hutscape/pine/readme.md

# Pine

> 🌲 Indoor Infrared receiver and transmitter with temperature sensor 🎐

Visit [hutscape.com/pine](https://hutscape.com/pine) for more details.

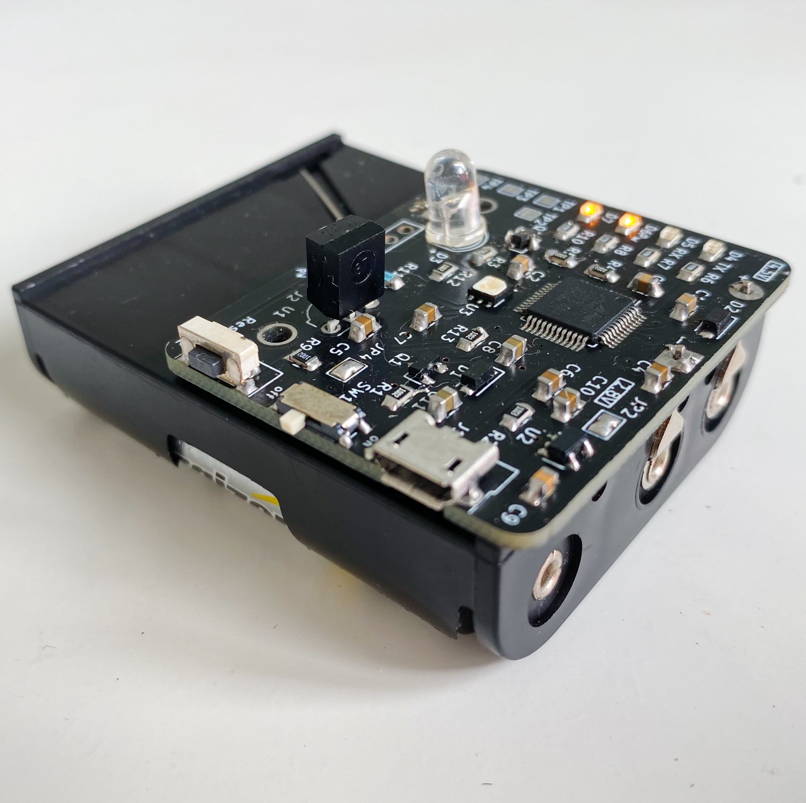
[picture p1: images/prototype/front.jpg]
