hutscape/pine/hardware.md

---
layout: pcb
title: PCB
permalink: /pcb
sequence: 2

three_d: true
pcb_layout: true
manufacturing: false
gerber: true
---
