hutscape/pine/index.md

---
layout: start
title: Start
permalink: /
sequence: 1

manufacturing: true
downloads:
  code: true
  schematic: true
  layout: true
  kicad: true
  gerber: true
  bom: true
  freecad: false
  case: false
features:
  - detail: Record and store the ON and OFF aircon commands with IR receiver
  - detail: Turn on or off the aircon with the IR emitter
  - detail: Measure temperature of another part of the room
  - detail: Go into sleep mode after turning on or off the aircon
---
