hutscape/pine/_code/demo.md

---
layout: code
title: Demo
description: Send ON and OFF commands to the aircon
difficulty: medium
features:
  - infrared
  - IR
  - emit
  - aircon
images:
  console: demo-console.png
references:
  - name: Use Arduino AVR Board version 1.6.21
    url: https://forum.arduino.cc/index.php?topic=574020.0
  - name: IRLib2 for Arduino Infrared
    url: https://github.com/cyborg5/IRLib2
  - name: Raw emit code example
    url: https://github.com/cyborg5/IRLib2/blob/master/IRLib2/examples/rawSend/rawSend.ino
---
