hutscape/pine/pcb/pcb.md

---
layout: pcb
title: PCB
permalink: /pcb
sequence: 2

# maximum number of images prototype-n.jpg in folder images/pcb/prototype
max_prototype_images: 3

three_d: true
pcb_layout: true
manufacturing: false
gerber: true
---
