hutscape/pine/_code/ir-receive.md

---
layout: code
title: IR receive
description: Receive and display raw IR code
difficulty: medium
features:
  - infrared
  - IR
  - receive
  - aircon
references:
  - name: Use Arduino AVR Board version 1.6.21
    url: https://forum.arduino.cc/index.php?topic=574020.0
  - name: IRLib2 for Arduino Infrared
    url: https://github.com/cyborg5/IRLib2
  - name: Raw receive code example
    url: https://github.com/cyborg5/IRLib2/blob/master/IRLib2/examples/rawRecv/rawRecv.ino
---
