hutscape/pine/_code/ir-raw-emit-zero.md

---
layout: code
title: Emit raw infrared code
description: This code takes in a raw dump of IR and emits it using Arduino Zero with SAMD21G micro-controller on a crystalless custom PCB.
difficulty: medium
features:
  - infrared
  - IR
  - emit
  - raw

references:
  - name: Use Arduino AVR Board version 1.6.21
    url: https://forum.arduino.cc/index.php?topic=574020.0
  - name: IRLib2 for Arduino Infrared
    url: https://github.com/cyborg5/IRLib2
  - name: Raw emit code example
    url: https://github.com/cyborg5/IRLib2/blob/master/IRLib2/examples/rawSend/rawSend.ino
---
