hutscape/pine/images/design/subsystem.png

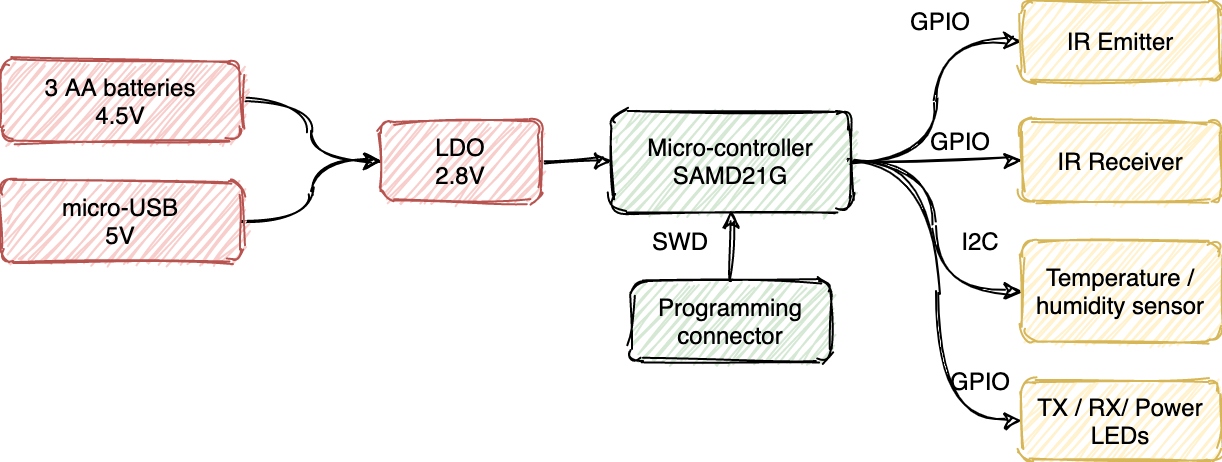
images/design/subsystem.png
