hutscape/pine/images/lessons/9-pin-jtag-swd-pins.png

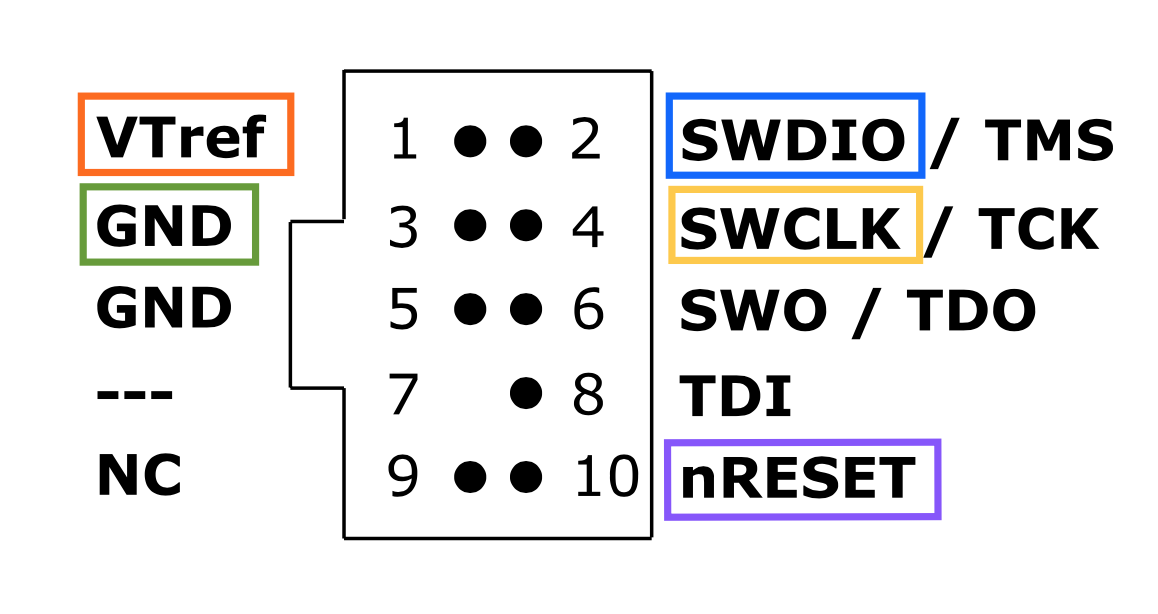
images/lessons/9-pin-jtag-swd-pins.png
