hutscape/pine/images/pcb/3dview-front.png

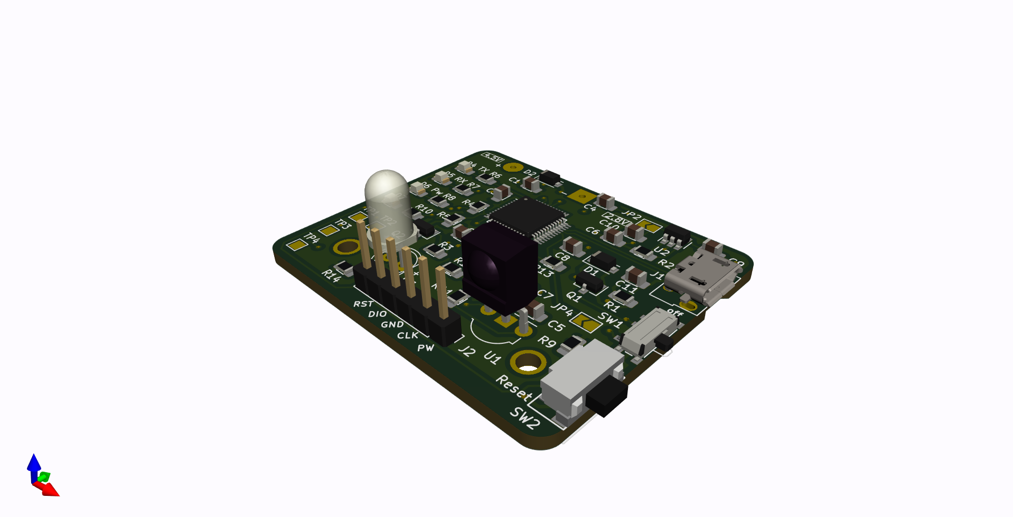
images/pcb/3dview-front.png
