hutscape/pine/images/pcb/3dview-side1.png

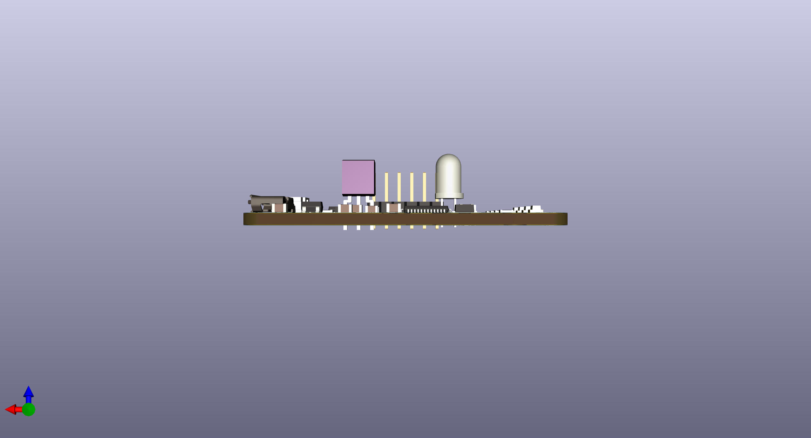
images/pcb/3dview-side1.png
