hutscape/pine/images/pcb/3dview-side2.png

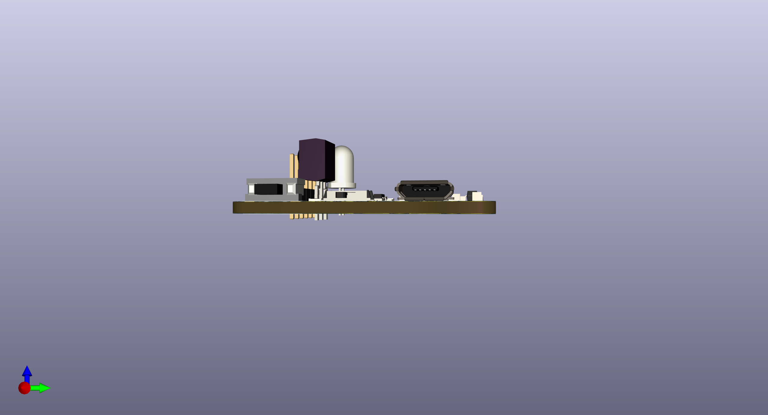
images/pcb/3dview-side2.png
