hutscape/pine/images/pcb/3dview-side4.png

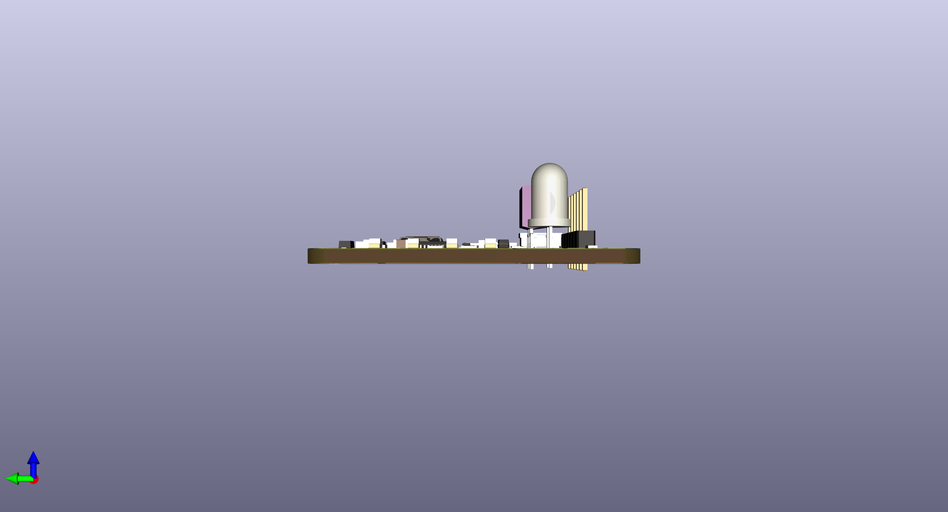
images/pcb/3dview-side4.png
