hutscape/pine/images/pcb/layout-back.png

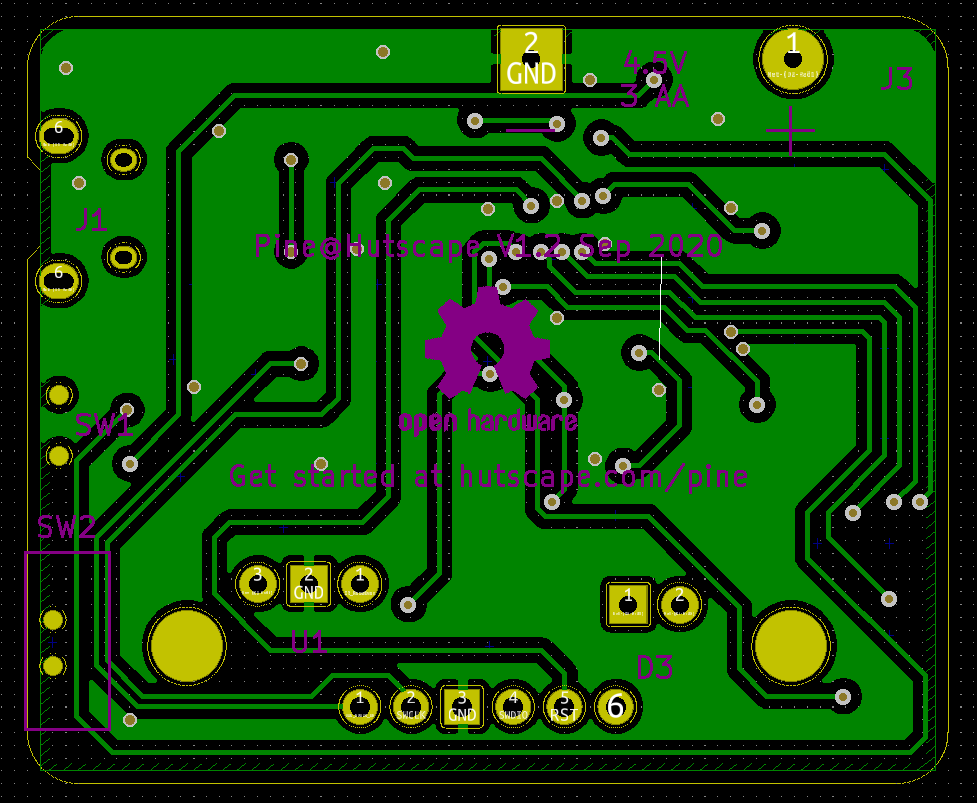
images/pcb/layout-back.png
