hutscape/pine/images/pcb/layout-front.png

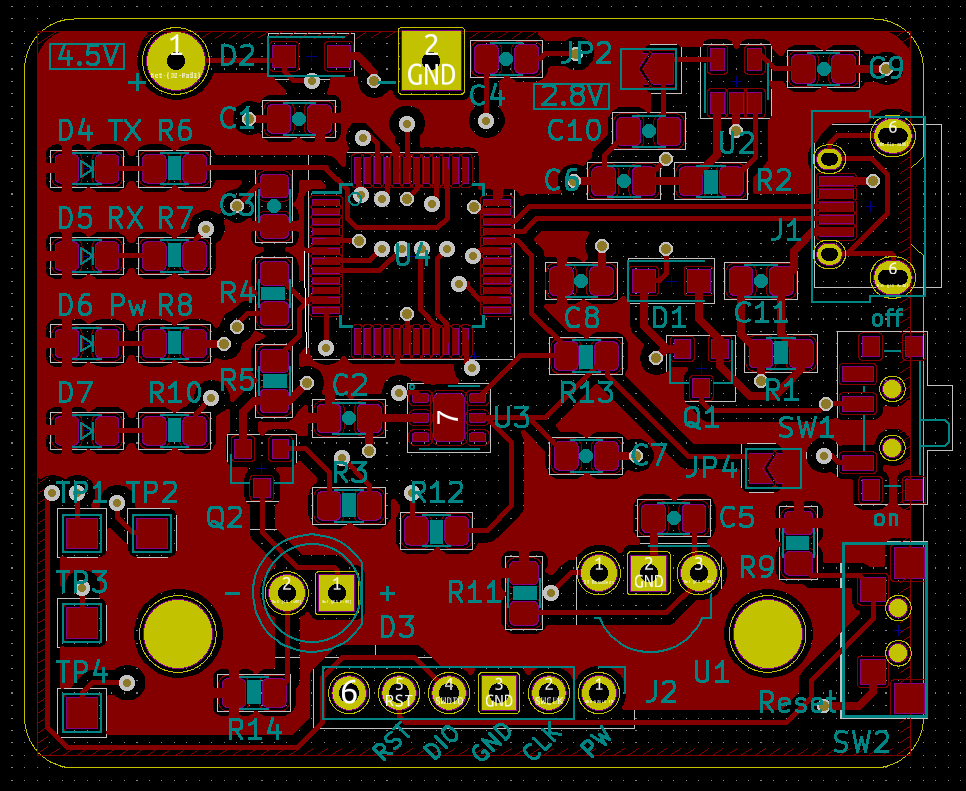
images/pcb/layout-front.png
