hutscape/pine/images/pcb/schematic.png

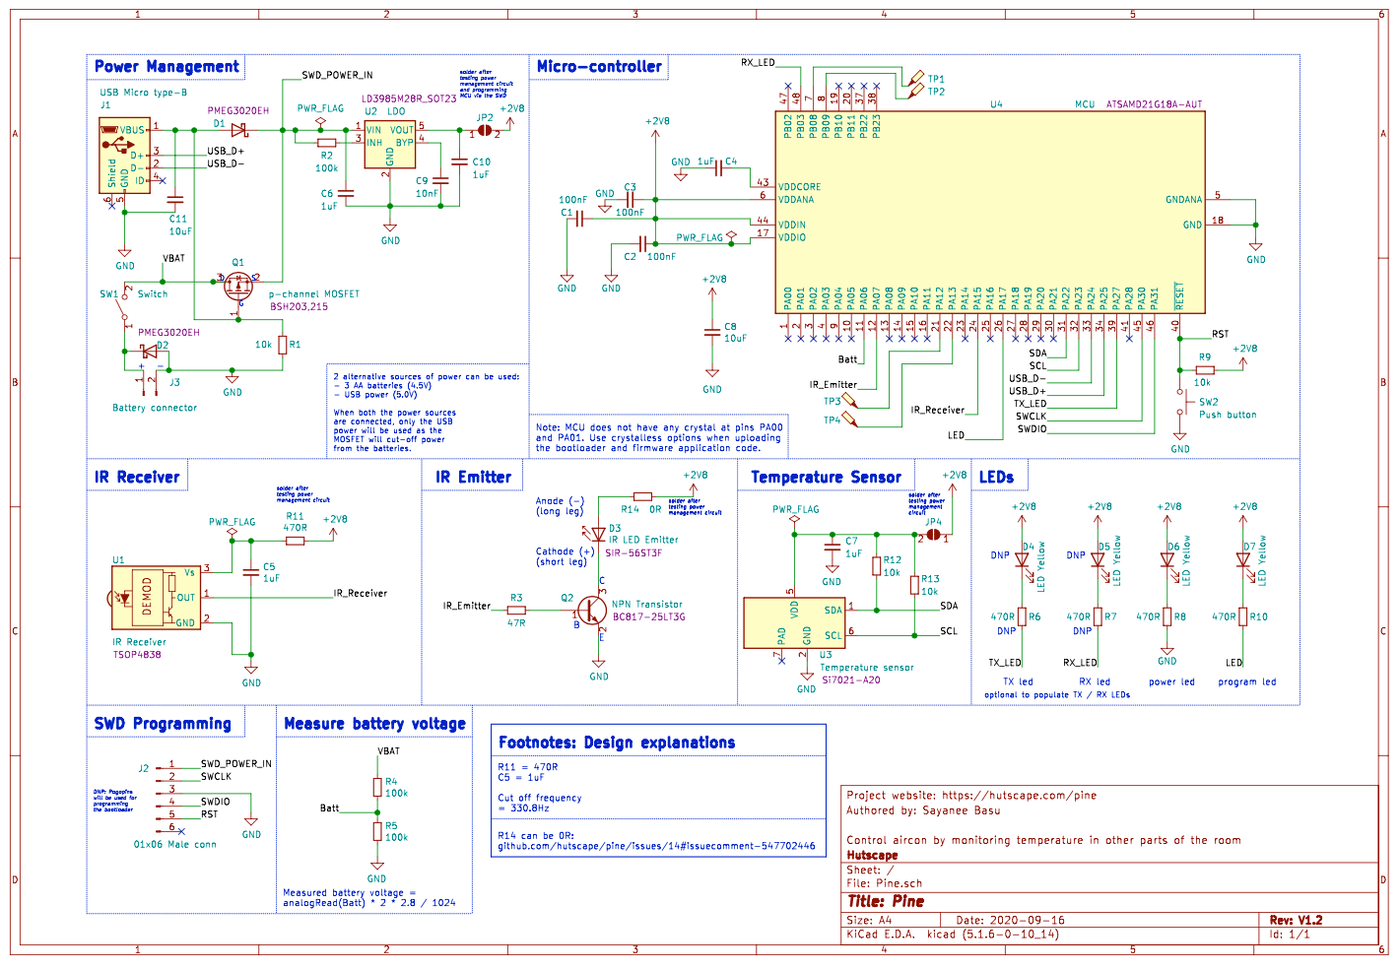
images/pcb/schematic.png
