hutscape/pine/images/power/power_tree.png

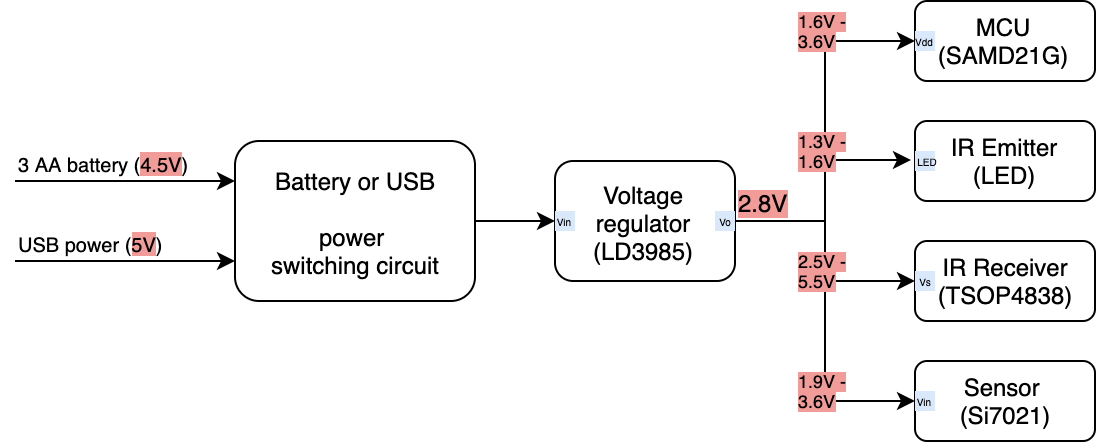
images/power/power_tree.png
