hutscape/pine/images/prototype/back.jpg

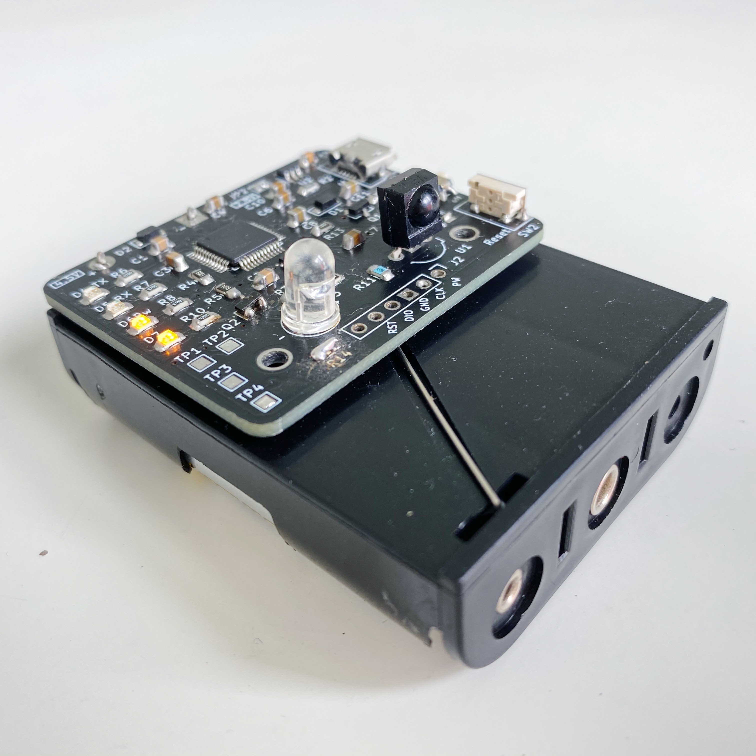
images/prototype/back.jpg
