hutscape/pine/images/prototype/prototype-2.jpg

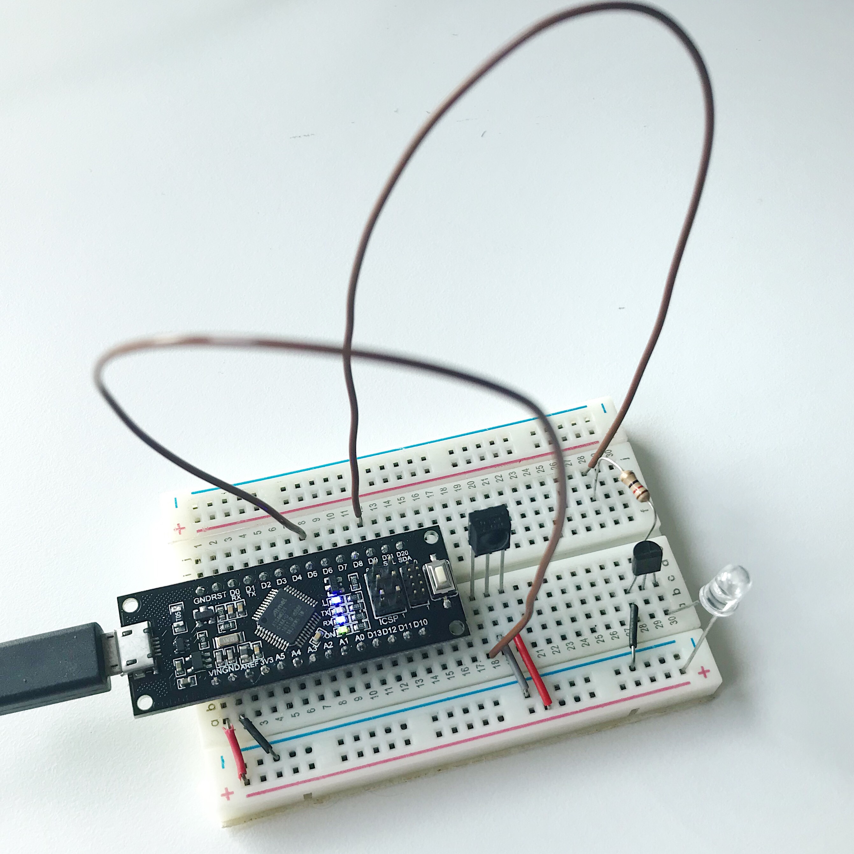
images/prototype/prototype-2.jpg
