hutscape/pine/images/prototype/prototype-3.jpg

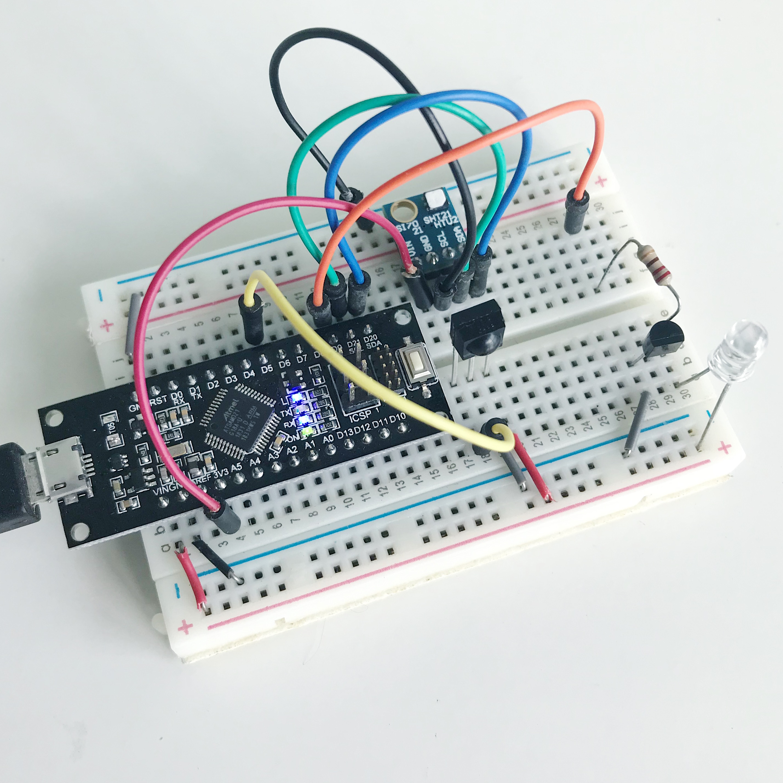
images/prototype/prototype-3.jpg
