hutscape/pine/images/prototype/side.jpg

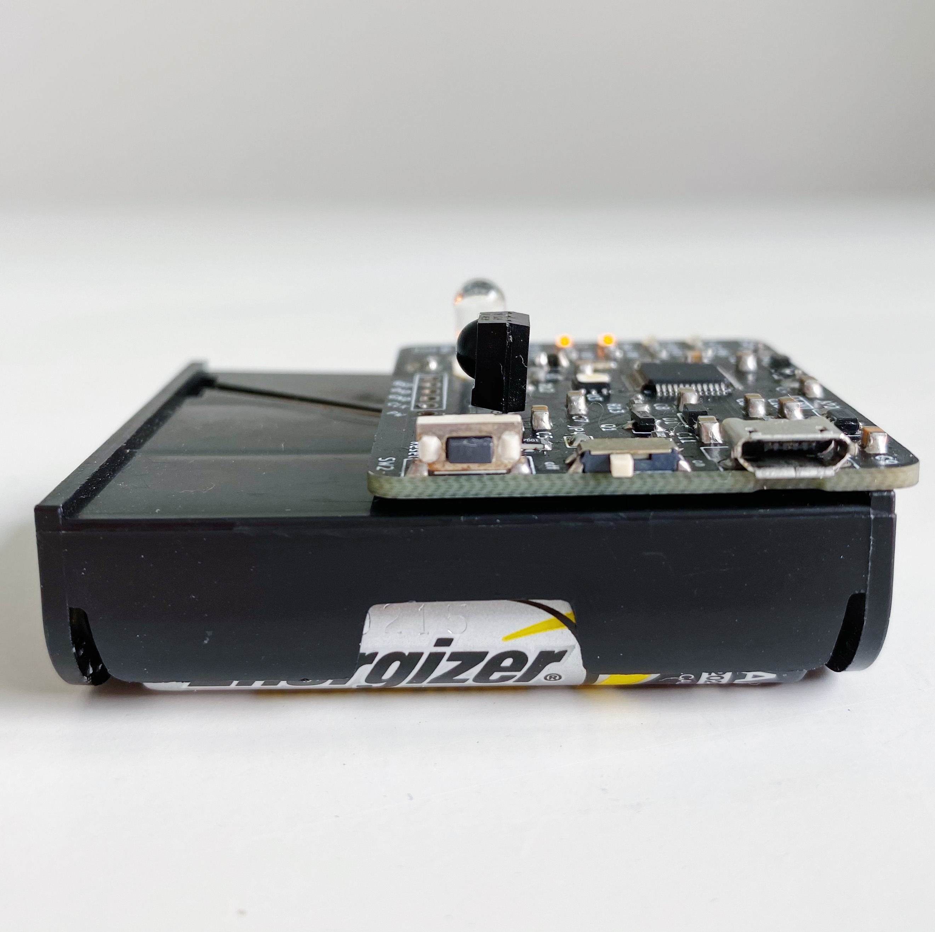
images/prototype/side.jpg
