hutscape/pine/images/prototype/top.jpg

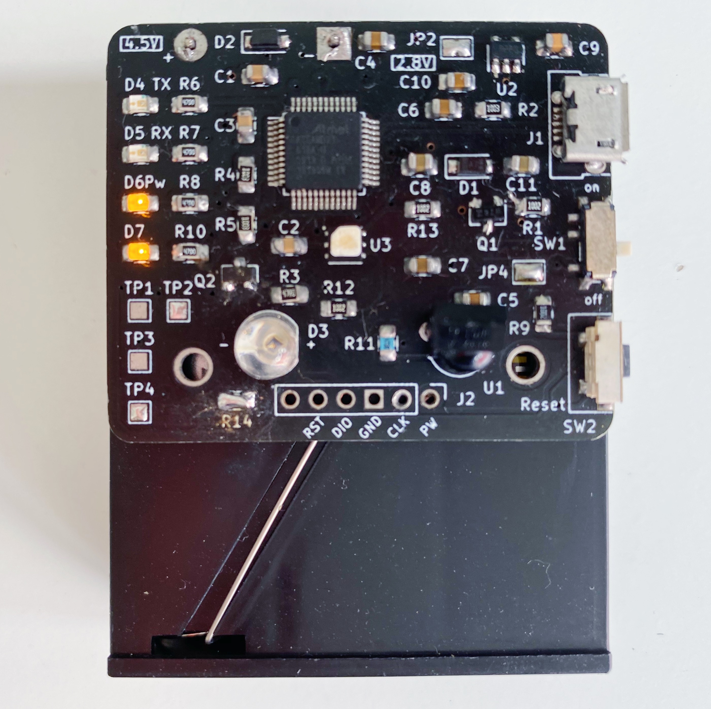
images/prototype/top.jpg
