hutscape/pine/start/step1.md

**Battery holder**

The PCB has 2 battery holder connector holes that can be used to attach the battery holder.

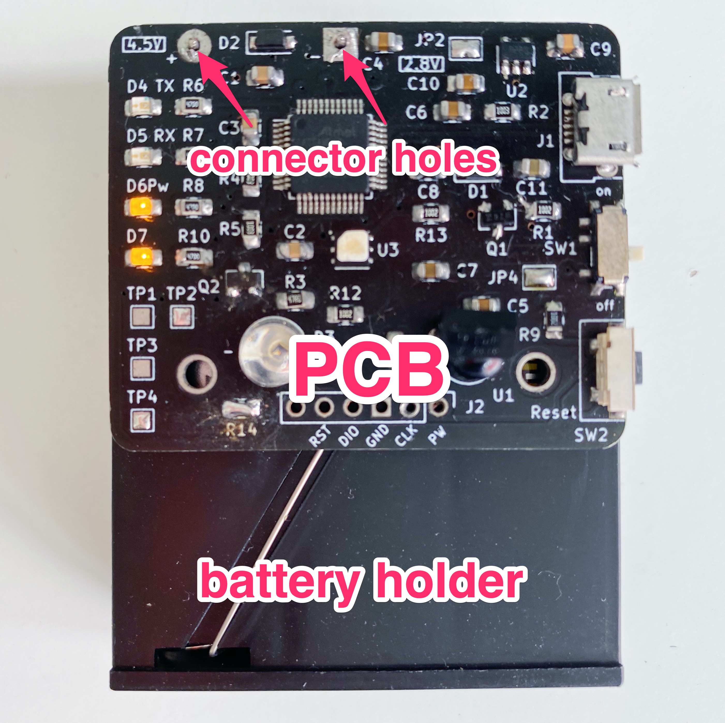
[picture p27: images/prototype/pcb-connector.jpg]
PCB battery connector holes


**Batteries**

Put in 3 AA batteries and turn on the switch. The power LED should turn on.

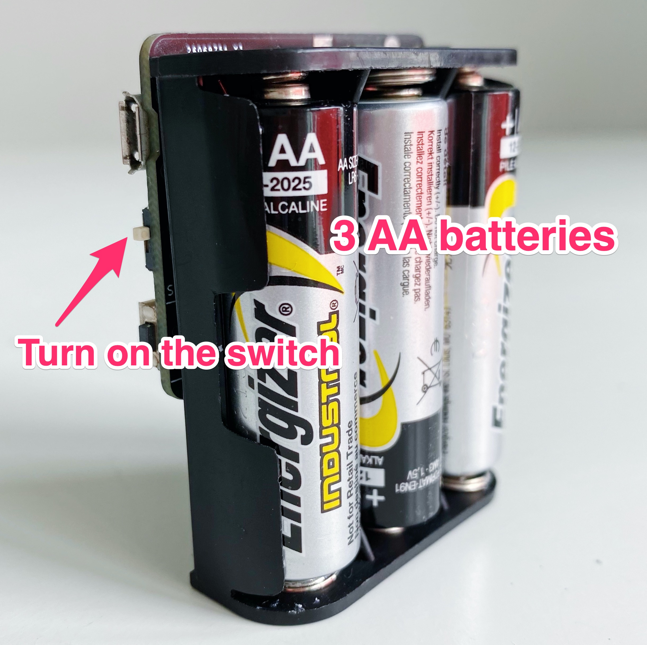
[picture p28: images/prototype/battery.jpg]
PCB with battery holder
