hutscape/pine/start/step2.md

**Upload the firmware**

Flash the [firmware](software#firmware) onto the Arduino Zero compatible board with a micro-USB cable.

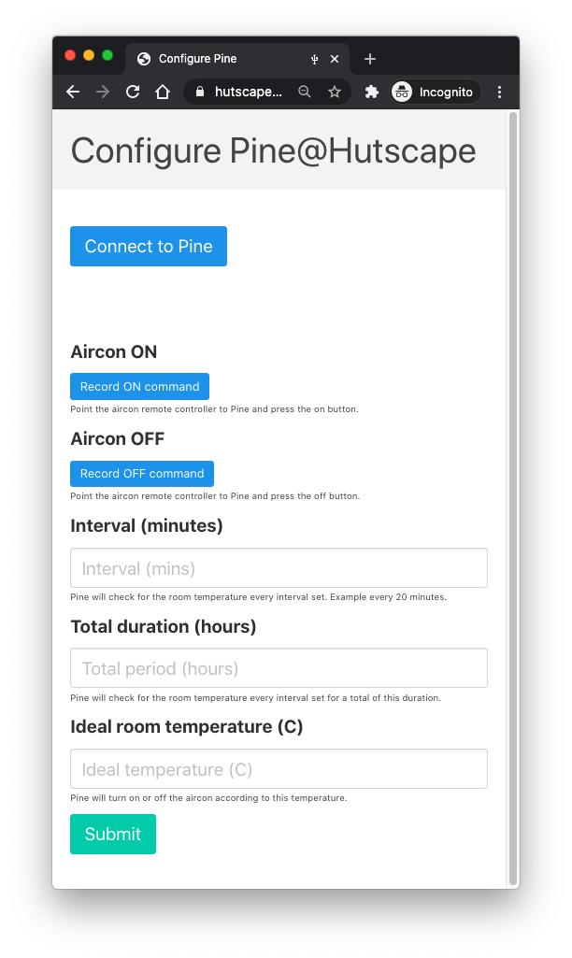
[picture p29: images/prototype/setup-page.png]
Web USB setup page


**Serial monitor**

Connect to the serial monitor to see the debug messages.

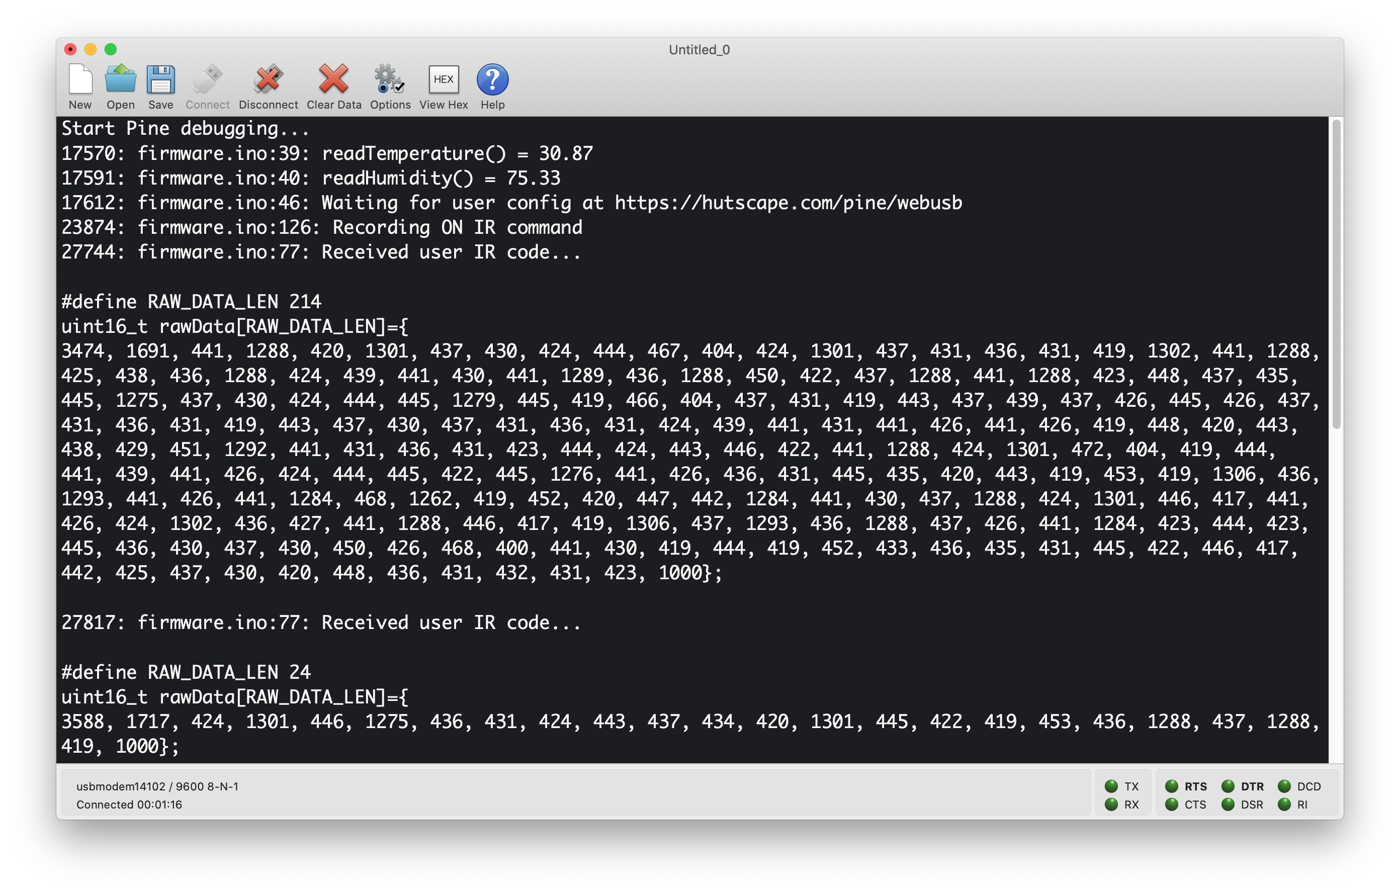
[picture p30: images/prototype/serial.png]
Serial console
