hutscape/pine/start/step3.md

<!-- TODO: Program the actual sleep and turning on to check the temperature -->
**Notice that the aircon should turn ON and OFF every 5 seconds as a test.**
