hutscape/pine/_code/test.md

---
layout: code
title: Pine test
description: Run a verification test to ensure all features are working
difficulty: medium
features:
  - infrared
  - IR
  - emit
  - aircon
images:
  console: test-console.png
references:
  - name: Use Arduino AVR Board version 1.6.21
    url: https://forum.arduino.cc/index.php?topic=574020.0
  - name: IRLib2 for Arduino Infrared
    url: https://github.com/cyborg5/IRLib2
---
