hutscape/pine/_code/measure-battery-zero.md

---
layout: code
title: Measure battery voltage
description: VBAT is connected to the battery or voltage source you wish to measure the voltage of.
difficulty: easy
features:
  - battery
  - voltage

images:
  console: measure-battery-zero-console.png
  schematic: measure-battery-zero-schematic.png
references:
  - name: Adafruit Feather M0 Adalogger
    url: https://learn.adafruit.com/adafruit-feather-m0-adalogger/power-management
---
