hutscape/pine/images/code/test-console.png

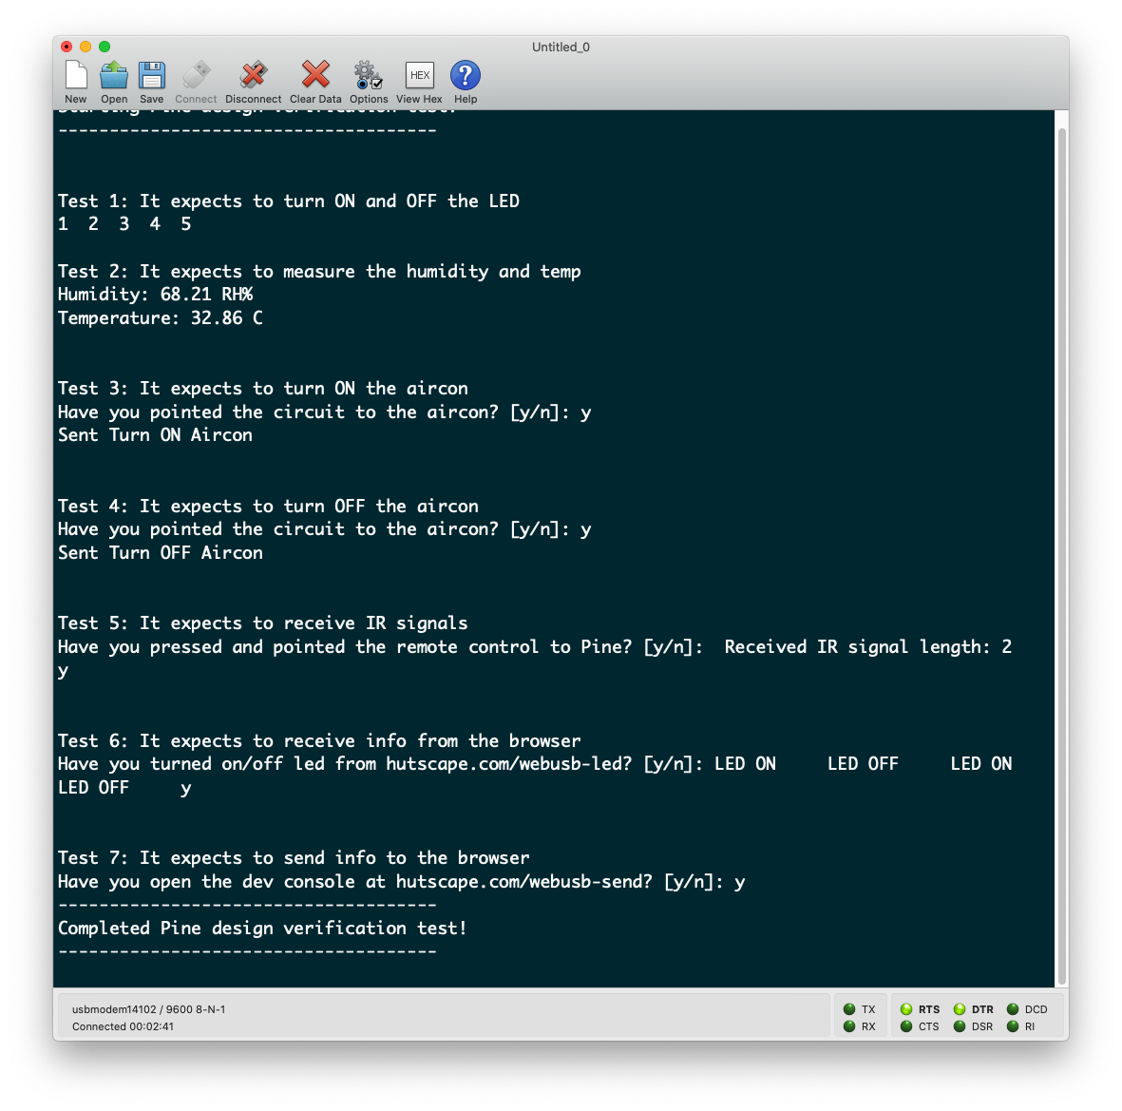
images/code/test-console.png
