hutscape/pine/(threads)

Thread 2 (2019-09-22):

Create new footprint for USB Micro-B

sayanee, 2019-09-22:
- [Datasheet](https://datasheet.lcsc.com/szlcsc/Jing-Extension-of-the-Electronic-Co-LCSC-MICRO-USB-5S-B-Type-horns-High-temperature_C10418.pdf)
    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
- [Vendor](https://lcsc.com/product-detail/USB-Connectors_Jing-Extension-of-the-Electronic-Co-Jing-Extension-of-the-Electronic-Co-MICRO-USB-5S-B-Type-horns-High-temperature_C10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)
- Edit from existing footprint: `USB_Micro-B_Amphenol_10103594-0001LF_Horizontal`
    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

sayanee, 2019-09-23:
Edited footprint:

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

Closed with https://github.com/hutscape/kicad-library/commit/c9657751e4f665b2ee2351194562116754cd3596

Closed 2019-09-23.

Thread 3 (2019-09-23):

Connect GND of measuring batt to a digital GPIO pin

sayanee, 2019-09-23:
> Little suggestion for your battery level measurements (you probably just didn't need this optimization yet): You can replace the GND with a GPIO that you ground only when you do the measures and set as output otherwise (high impedance).

~ [source](https://twitter.com/CedHon/status/1176085302055772160)

sayanee, 2019-09-23:
## Before:

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

## After:

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

Closed 2019-09-23.

Thread 4 (2019-09-23):

Improve power management circuit

sayanee, 2019-09-23:
> Remove D2 and reverse Q1. I use the circuit below. P1 is the battery, +5V is from USB

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

~ [source](https://twitter.com/ba0sh1/status/1176122249473978369) 🙏 Thanks Baoshi

sayanee, 2019-09-24:
Improved
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

sayanee, 2019-09-24:
Closed with 0bb40f7d23860e881d780033c68239684d94a1af

Closed 2019-09-24.

Thread 5 (2019-09-24):

Optimize power savings for power LED

sayanee, 2019-09-24:
> You also have an LED that's always on, maybe that's not mandatory. And it can be nice to double-check that the default state of this "switchable ground" GPIO is set as input by (hardware) default.

~ [Source](https://twitter.com/CedHon/status/1176176275268034560)

sayanee, 2019-10-25:
Something to think about in future projects, especially for a low power device! For now, just de-solder the resistor if required.

Closed 2019-10-25.

Thread 6 (2019-09-24):

Pull out some unused pins for future experimentation

sayanee, 2019-09-24:
> (+ adding a couple of test points on unused GPIOs can't hurt!)

~ [source](https://twitter.com/CedHon/status/1176176275268034560)

Example from [PRJC teensy](https://www.pjrc.com/store/teensy36b.jpg)

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

sayanee, 2019-10-24:
Using schematic:

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

Using footprint:

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

sayanee, 2019-10-25:
## Schematic

`TP1`, `TP2`, `TP3`, `TP4`

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

## Layout

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

Closed 2019-10-25.

Thread 7 (2019-09-24):

Add reference URLs for power measurement

sayanee, 2019-09-24:
- [Measuring Lithium battery voltage with nRF52](https://devzone.nordicsemi.com/nordic/nordic-blog/b/blog/posts/measuring-lithium-battery-voltage-with-nrf52) from [source](https://twitter.com/CedHon/status/1176431072583868416)
- [RC Charging circuit](https://www.electronics-tutorials.ws/rc/rc_1.html) from [source](https://twitter.com/CedHon/status/1176425937153515523)

Closed 2019-10-24.

Thread 8 (2019-10-23):

Add 3D models in proper paths and credits

sayanee, 2019-10-23:
- [smd side push button](https://grabcad.com/library/smd-side-push-button-2x4x3-5-mm-1)
- [micro USB](https://grabcad.com/library/micro-usb-1)

sayanee, 2019-10-24:
- Added 3d models folder: https://github.com/hutscape/kicad-library/tree/master/3d_models
- Check `readme.md`: https://github.com/hutscape/kicad-library#3d-models

Closed 2019-10-24.

Thread 9 (2019-10-24):

Improve component placement

sayanee, 2019-10-24:
Thanks @notthetup 🙇‍♀

- [x] Micro USB jutting outwards or inwards for edge cut
- [x] Create custom footprint for diode and LEDs to show the direction https://github.com/hutscape/kicad-library/commit/fab1f1fe7deaafd18e501e6e459cb8820d0edcaf
- [x] Associate all LED, diodes, Resistors, Capacitors to the new footprint!
- [x] Label ON / OFF for SW1 on the silkscreen
- [x] remove the triangle in Micro USB silkscreen
- [x] Increase height of the PCB edge cut by 1 grid of 25 mils above the battery connectors
- [x] Label all connected pins of the `SWD` header
- [x] Create more space around bigger components for soldering

sayanee, 2019-10-24:
✅ Increase the height of the PCB edge cut by 1 grid of `25 mils` above the battery connectors

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

sayanee, 2019-10-24:
✅ Micro USB jutting outwards or inwards for edge cut
✅ Remove the triangle in Micro USB silkscreen

## Before

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

## After

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

sayanee, 2019-10-24:
✅ Label ON / OFF for SW1 on the silkscreen

## Before

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

## After

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

sayanee, 2019-10-24:
## Before

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

## After

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

Closed 2019-10-24.

Thread 11 (2019-10-26):

Update power tree schematic with the new LDO

sayanee, 2019-10-26:
https://hutscape.com/pine/power#main-components

sayanee, 2019-10-27:
Closed with https://github.com/hutscape/pine/commit/4b87898ae2660ef1557bcb1c2a032019eb097d80

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

Closed 2019-10-27.

Thread 13 (2019-10-26):

Find out KiCad shortcuts

sayanee, 2019-10-26:
- drag traces
- change from front to back layers and vice versa
- draw traces, drop via, continue on the bottom layer

Thread 14 (2019-10-27):

Comments on routing / layout

sayanee, 2019-10-27:
from @notthetup

- [x] `M2` drill holes should be non-plated and non-conducting
- [x] Check the clearance for traces near the drill holes
- [x] TH for `SW1` and `SW2` should be non-plated

from @catmaker

- [x] Link `BATT_EN` to `GND` or an FET 75e1301ccccc7d52c6a0b5bb4e9a9f3ccf367959

> Without download the datasheet of ATSAM, I can observe you're stressing the `PA06` & `PA16` (`batt` & `batt_en`) pins. Despite the limiting the current with `100kohms`, you're back-powering the MCU at whatever batt voltage when the CPU is only at 2.8V. That stress can cause strange behavior over time.

> In the past, I read in (I think) Energizer AA Alkaline Spec/AppNote that anything less than 50uA loading is better than its self-discharge (kind of like the battery's shelf-life) and is good for off-state of consumer goods. 4.5V / 200000 = 22.5uA, so that's good. But your LDO consumes > 85uA, not the best. The good ones I've used in the past were Microchip MCP1703 (2uA) and OnSemi NCP170 (0.5uA) These little savings can add up to your longer batt life.

> If the batt reader is really a drainer, then the solution is a P-MOSFET at the top-arm of your potential divider, but that needs to pull down to turn on, so an inverting transistor logic might be necessary -- additional components

- [x] Interchange `S` and `D` for symbol `BSH203` https://github.com/hutscape/pine/commit/6327a1abf4abe902c7cc7e73cfac4355dcd7c542

> the symbol for BSH203 looks like source and drain reversed. it's only the letters S & D that are interchanged. for sot23 or other 3-pin smt mosfets, they're pretty much standard. 1,2,3=g,s,d.

- [x] Remove an extra solder jumper bb0ccd3980dc61c12f9f01d6dd0fe4af4ed66e95

> JP1 looks redundant when `R11` can do the same

- [x] `D3` IR LED needs a series resistor 2239f77a734cb89488afc2f2a5789bc40af238e2

> are you controlling current through D3 IRLED with the transistor in linear region? You need to decouple the rail to the LED too, because it is a pulsating drain on the supply. In the past, we treated that NPN as a switch and control current along the LED. Although more expensive (cents) i will lazily use n-mosfet.

>  LED current is usually limited(controlled) by a series resistor. You can control an NPN current flow by controlling the base-current, multiplied by NPN's hfe, BUT this is exotic and probably not realizable (due to NPN manufacturing tolerances). So the common way is to treat that NPN as a quick on-off >switch<. So to control current, the series resistor is used.

> When batt power is low, and you xmit, the power rail is disturbed and possibly MCU is reset/browned-out prematurely. If you look at other similar circuits, the LED (only) is supplied by Vbatt, before the regulator.

@shannietron

- [ ] Add thermal reliefs on the solder jumper pads

> not a huge deal, but this pad doesn't have thermal relief.

- [x] Change to `GND` or add a FET to the battery measuring circuit 75e1301ccccc7d52c6a0b5bb4e9a9f3ccf367959

> the battery sense circuit, the Batt_EN is used to 'turn off' the sensing to save power but `Batt_EN` is at `2.8V` when high. your `VBAT` is going to be at `~3.7V`, and your `BAT_EN` will be at `2.8V`. you'll still have a current flow: `4.5µA`

sayanee, 2019-10-28:
`M2` drill holes are NPTH, mechanical

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

sayanee, 2019-10-28:
`SW1` has NPTH, mechanical drill hole

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

`SW2` has NPTH, mechanical drill hole

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

sayanee, 2019-10-29:
Interchange `S` and `D` for symbol `BSH203`

From the [datasheet](https://docs-apac.rs-online.com/webdocs/0f74/0900766b80f74f2c.pdf):

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

sayanee, 2019-10-30:
Link `BATT_EN` to `GND`

## Before

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

## After

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

sayanee, 2019-10-30:
#  `D3` IR LED needs a series resistor

## Calculate the value of the resistor

- `D3` IR LED Absolute maximum rating Pulse forward current is `500mA`
    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
- `80%` of maximum Pulse forward current is `400mA`
- `D3` IR Led forward voltage is `1.3V`
    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
- `Vce` is `2.8V - 1.3V = 1.5V`
    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
- `D3` IR LED PWM is at `38kHz` - ([reference](https://github.com/cyborg5/IRLib2/blob/167a9213262d3d5c969e887e48b8bd2d610811f2/IRLibProtocols/IRLib_HashRaw.h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))
- Maximum duty cycle of the raw IR code will be `3446 ms` or `3.446us` - ([reference](https://github.com/hutscape/pine/blob/75e1301ccccc7d52c6a0b5bb4e9a9f3ccf367959/firmware/data.h#L4))
- Approximate value of resistor = `1.5V / 400mA = 3.75Ω ≃ 0Ω`
- Safe operating area of `Q2` NPN Transistor
    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

## Value of resistor chosen

- `0Ω` or `10Ω`
- Replace `JP3` with ``0Ω` resistor

Closed 2019-11-06.

Thread 15 (2019-10-30):

Add firmware features

sayanee, 2019-10-30:
- [ ] Record and store IR raw codes, ideal temperature, interval and duration
- [ ] Measuring battery voltage
- [ ] Displaying low battery voltage with LED
- [ ] Sleep and wakeup periodically to check the temperature and turn on/off the aircon

sayanee, 2020-10-05:
- [ ] implement task with sleeping and wakeup
- [ ] fix form validation when IR raw code is added

Thread 16 (2019-11-06):

Replace schottky diode

sayanee, 2019-11-06:
## Before

**30V 2A** 430mV @ 2A **SOD-123F** Schottky Barrier Diodes (SBD) RoHS [MBR230LSFT1G](https://lcsc.com/product-detail/Schottky-Barrier-Diodes-SBD_ON-Semicon_MBR230LSFT1G_ON-Semicon-ON-MBR230LSFT1G_C126673.html)

## After

Nexperia **30V 2A**, Diode, 2-Pin **SOD-123F** [PMEG3020EH,115](https://sg.rs-online.com/web/p/rectifier-diodes-schottky-diodes/0485319/?sra=pstk)

Changes to make:

- [x] BOM
- [x] Schematic component info: datasheet, part no., vendor link

sayanee, 2019-11-14:
Closed with https://github.com/hutscape/pine/commit/ef6ed82db5cb6a8365c1f3287c254b81fa6909d8

Closed 2019-11-14.

Thread 17 (2019-11-17):

Silkscreen for SW1 is inverted.

notthetup, 2019-11-17:
SW1 turns on when the switch is in the downwards position. The silkscreen indicates otherwise.

Closed 2019-11-17.

Thread 18 (2020-07-01):

Touching the MCU will start the program

sayanee, 2020-07-01:
on the soldered PCB

sayanee, 2020-07-07:
Solved with #19

Closed 2020-07-07.

Thread 19 (2020-07-01):

Port will be detected upon intermittent plugging in and out the USB and pressing reset button

sayanee, 2020-07-01:
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

sayanee, 2020-07-07:
Solved by using the crystalless option for the PCB.

Details:

- [Bootloader for SAMD21G](https://hutscape.com/tutorials/arduino-bootloader-samd21g)
- [Flashing blinky firmware for SAMD21G ](https://hutscape.com/tutorials/blinky-samd21g)

Closed 2020-07-07.

Thread 20 (2020-07-07):

Temperature sensor does not work

sayanee, 2020-07-07:
# Logic Analyzer probed

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

# Serial monitor

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

sayanee, 2020-07-07:
Tested with another `Si7021` sensor and it works!

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

sayanee, 2020-08-05:
Replaced Si7021 chip. And it works now ✅

Closed 2020-08-05.

Thread 22 (2020-08-12):

IR LED is not working

sayanee, 2020-08-12:
Because `2N222A` pinout (used in breadboard) is different from `BC817`

# 2N222A

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

# BC817

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

## Differences

| Chip | PN222A | BC817 |
| ------ | ------ | ------ |
| Pin 1 | E | B
| Pin 2 | B | E
| Pin 3 | C | C

sayanee, 2020-08-12:
Changed schematic

## Before

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

## After

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

sayanee, 2020-08-12:
Change layout

sayanee, 2020-08-13:
closed with fbd26d9b4a6f8accae8da3f6b3ee31ed54a161b5

Closed 2020-08-13.

Thread 23 (2020-09-03):

Try uploading the bootloader by converting an ST-Link into a Black Magic Probe

sayanee, 2020-09-03:
Via [this link](https://microcontrollerelectronics.com/how-to-convert-an-stm32f103c8t6-into-a-black-magic-probe/)

As [suggested by Ubi](https://www.youtube.com/watch?v=h2nKROPlFy0&lc=Ugz_kLs8s2h8RKxxlqh4AaABAg.9BkZmUeflnr9Bka7kc6Eeu)

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

sayanee, 2020-09-05:
Trasferred

Closed 2020-09-05.
