hutscape/pine/pcb/docs/schematic.pdf

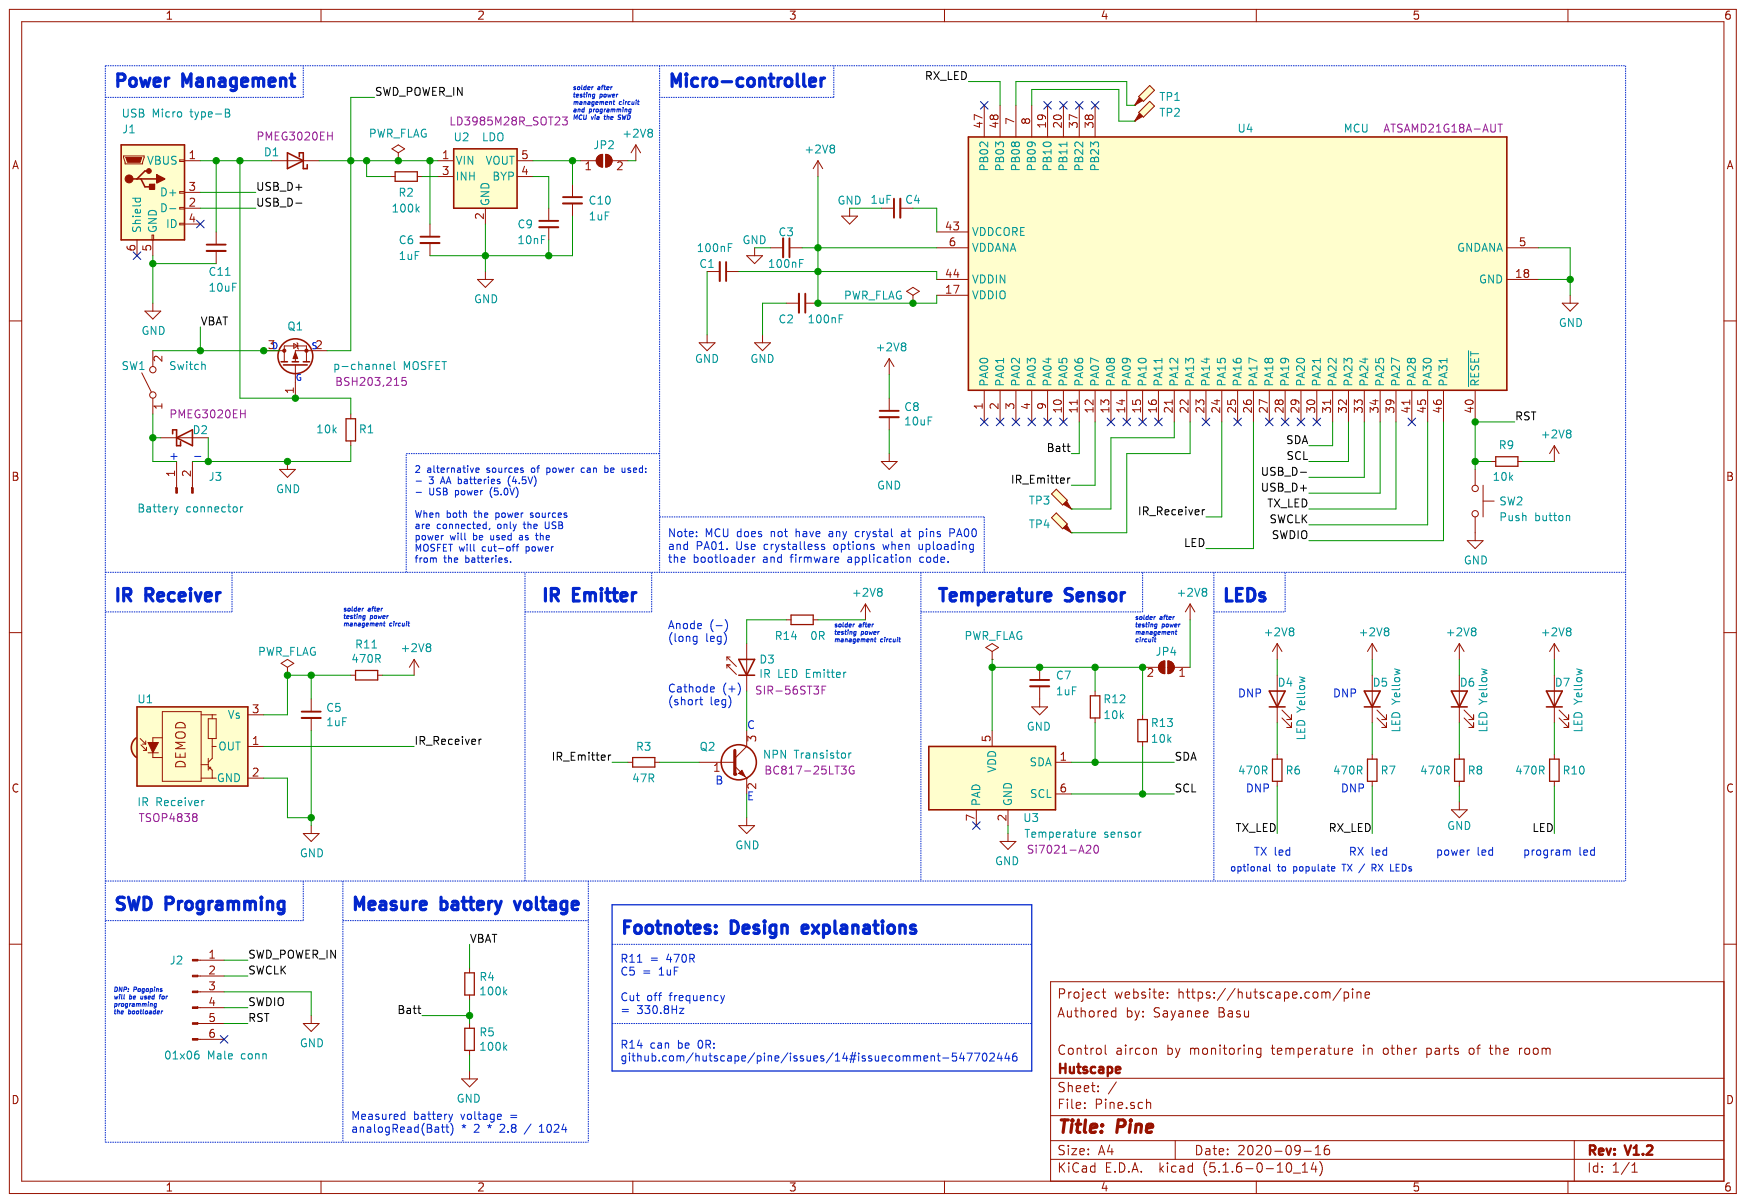
[picture p32: page 1]
