hutscape/pine/pcb/docs/layout.pdf

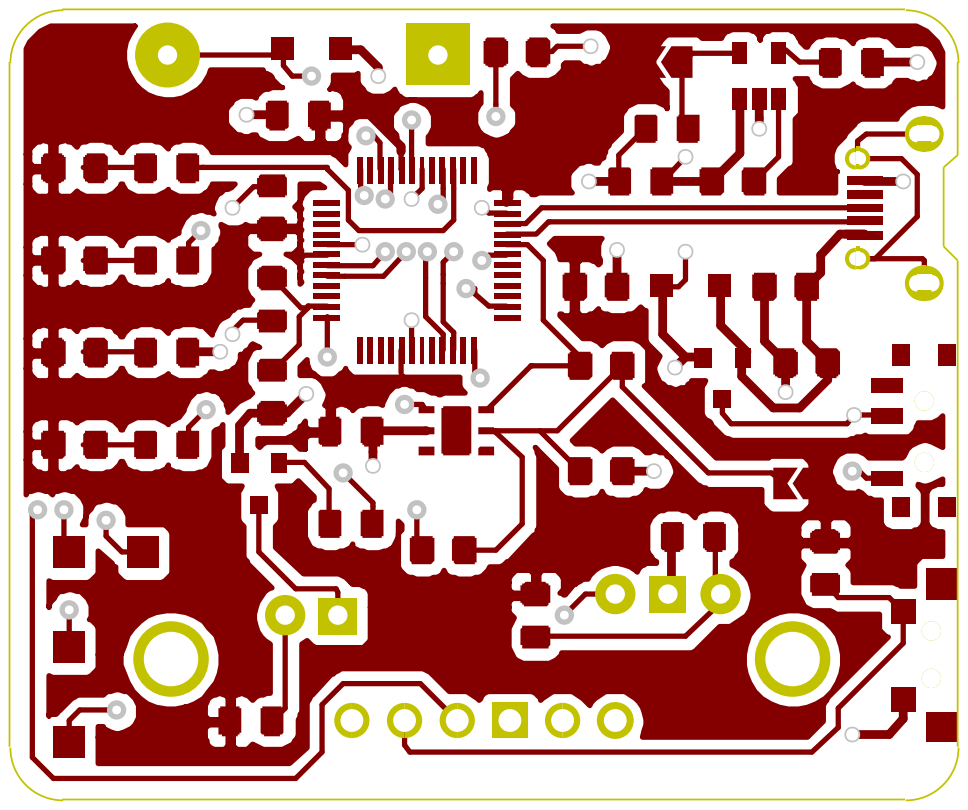
[picture p33: page 1]

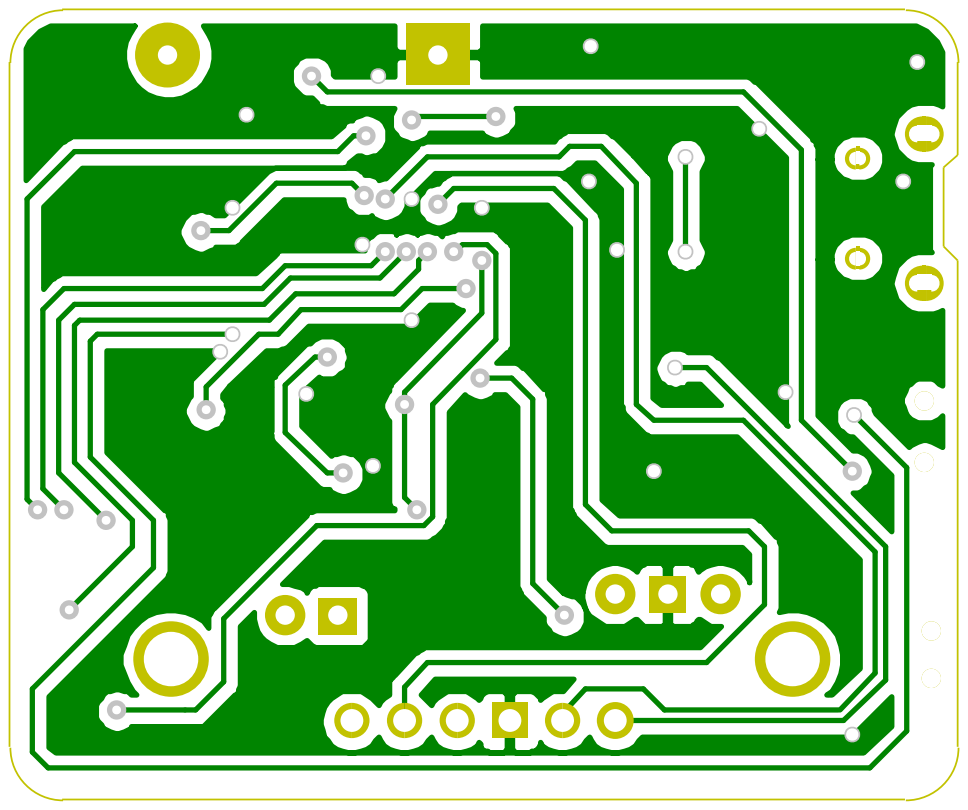
[picture p34: page 2]

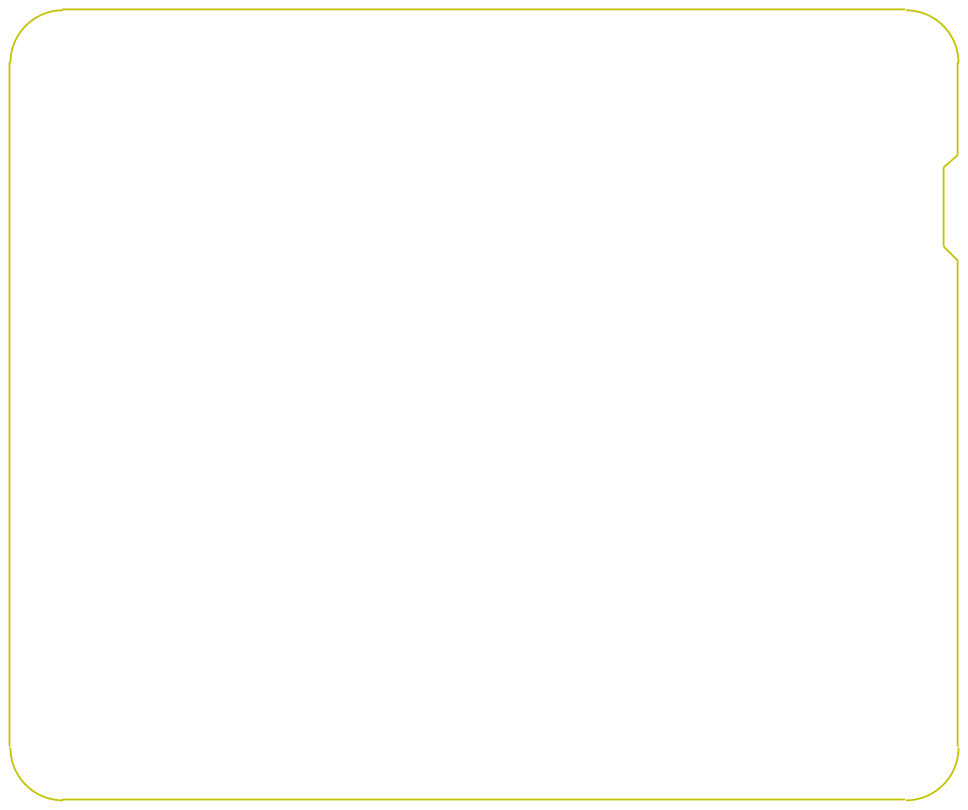
[picture p35: page 3]

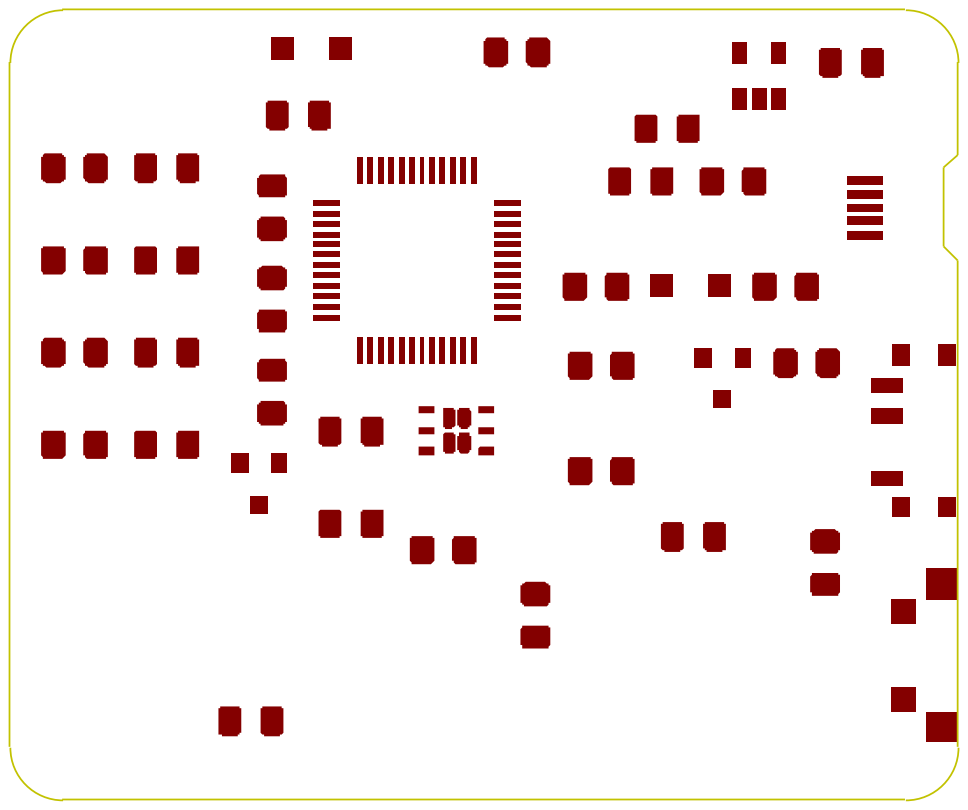
[picture p36: page 4]

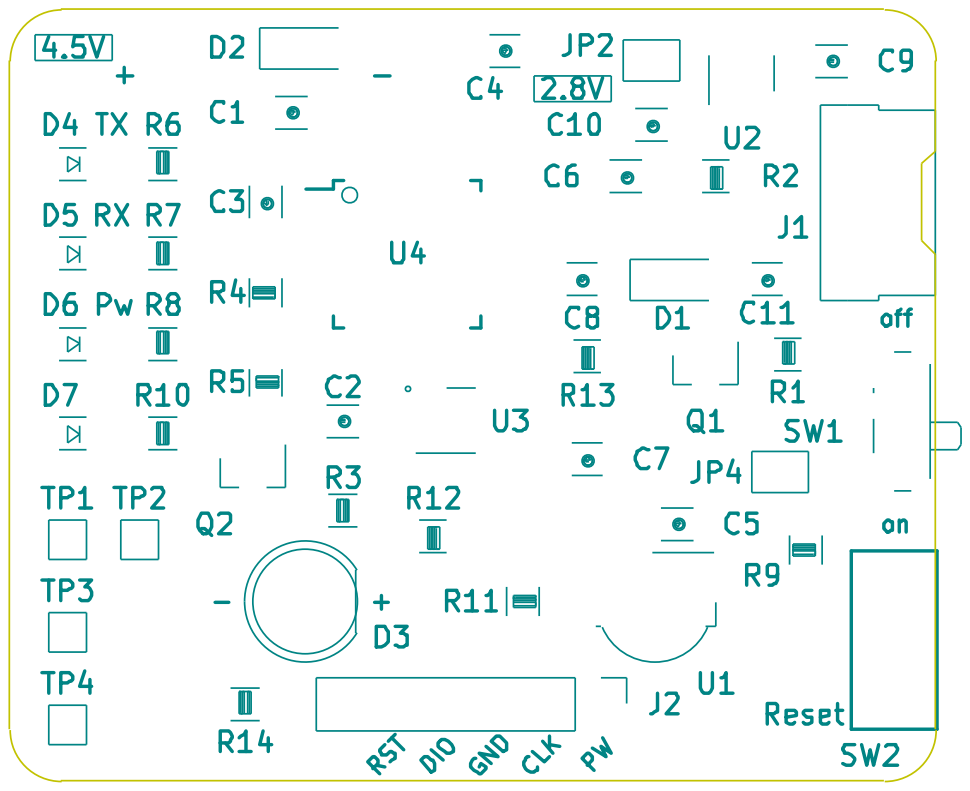
[picture p37: page 5]

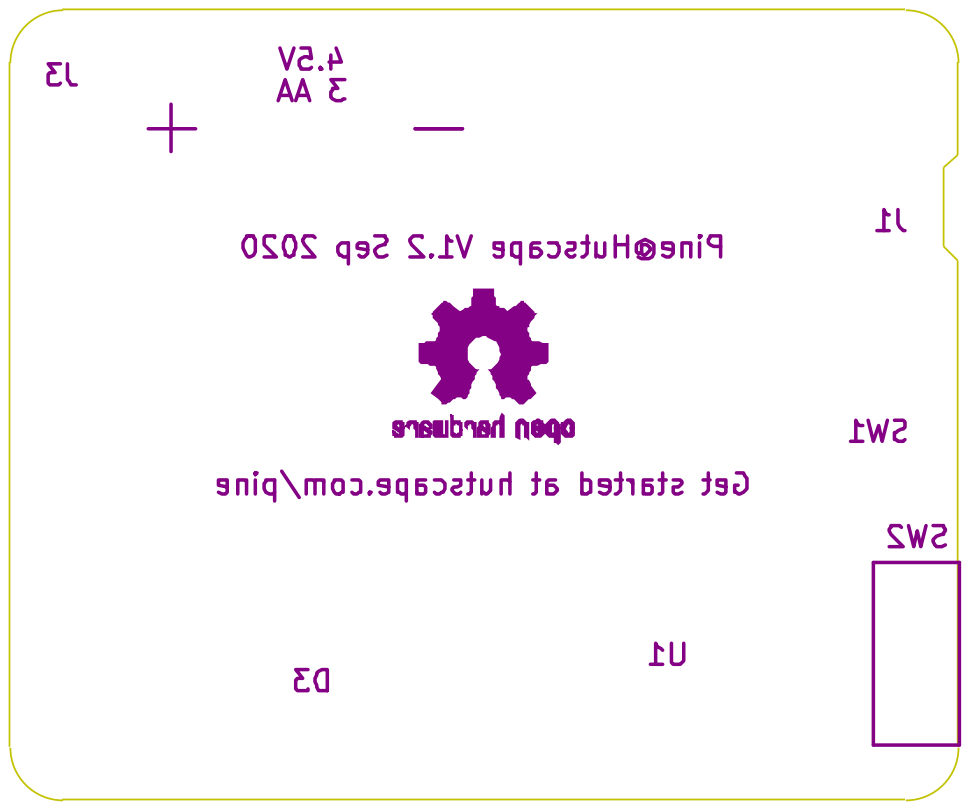
[picture p38: page 6]

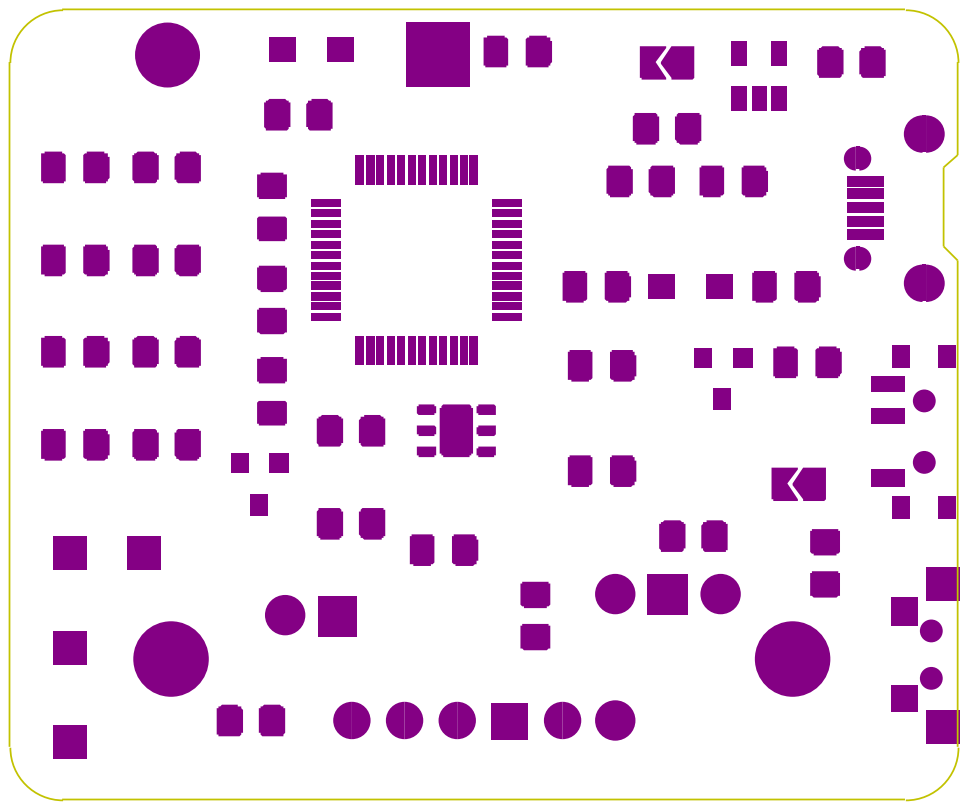
[picture p39: page 7]

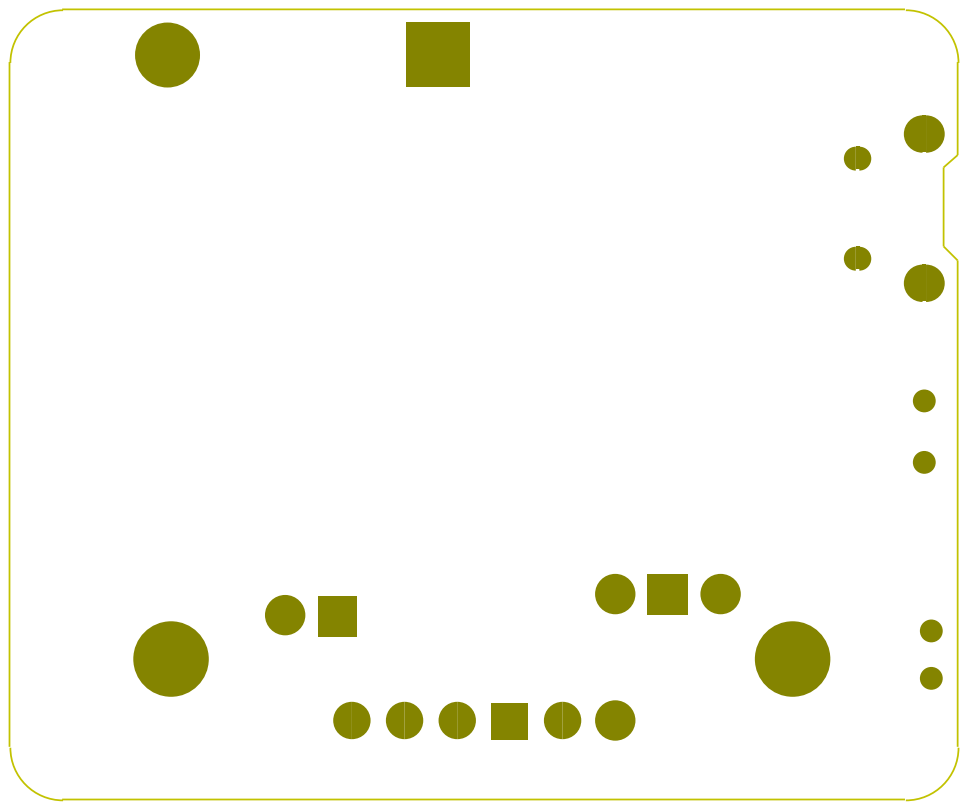
[picture p40: page 8]

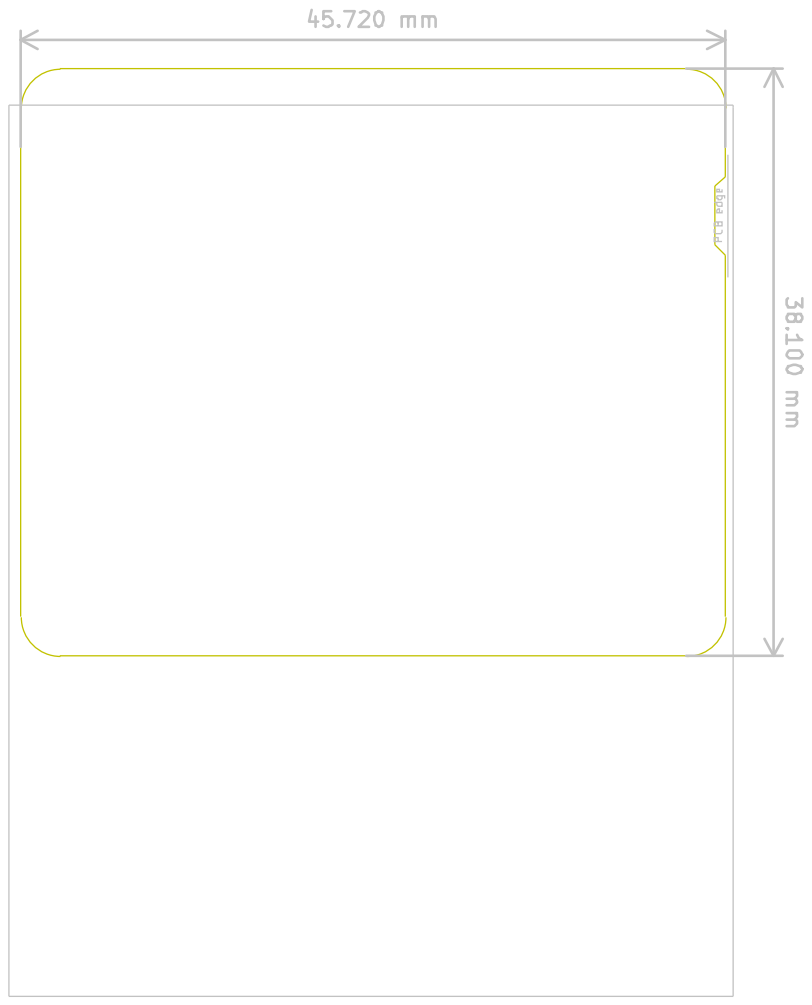
[picture p41: page 9]

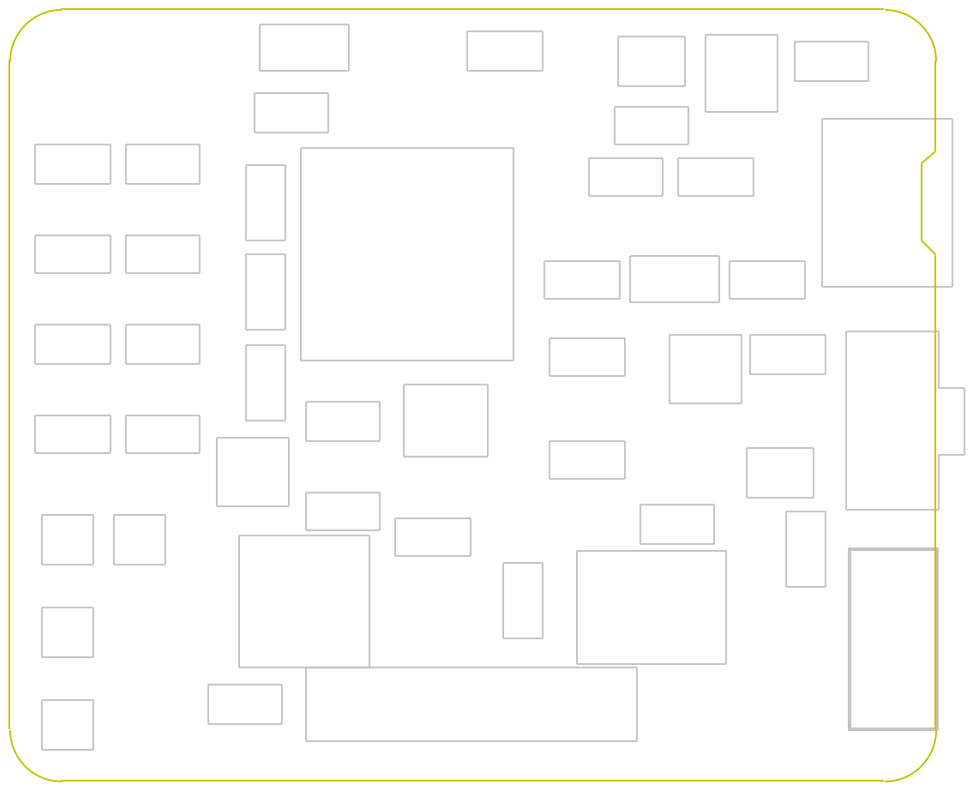
[picture p42: page 14]

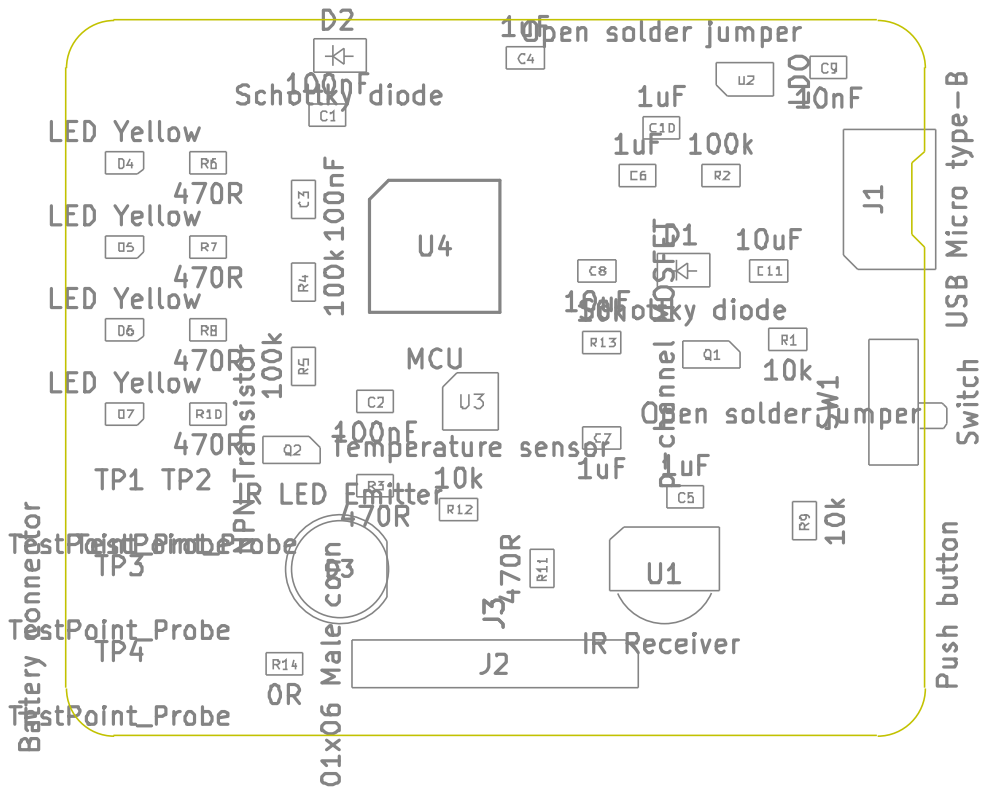
[picture p43: page 16]
