hutscape/pine/pcb/Pine.kicad_pcb

## KiCad design pcb/Pine.kicad_pcb (2020-09-16)

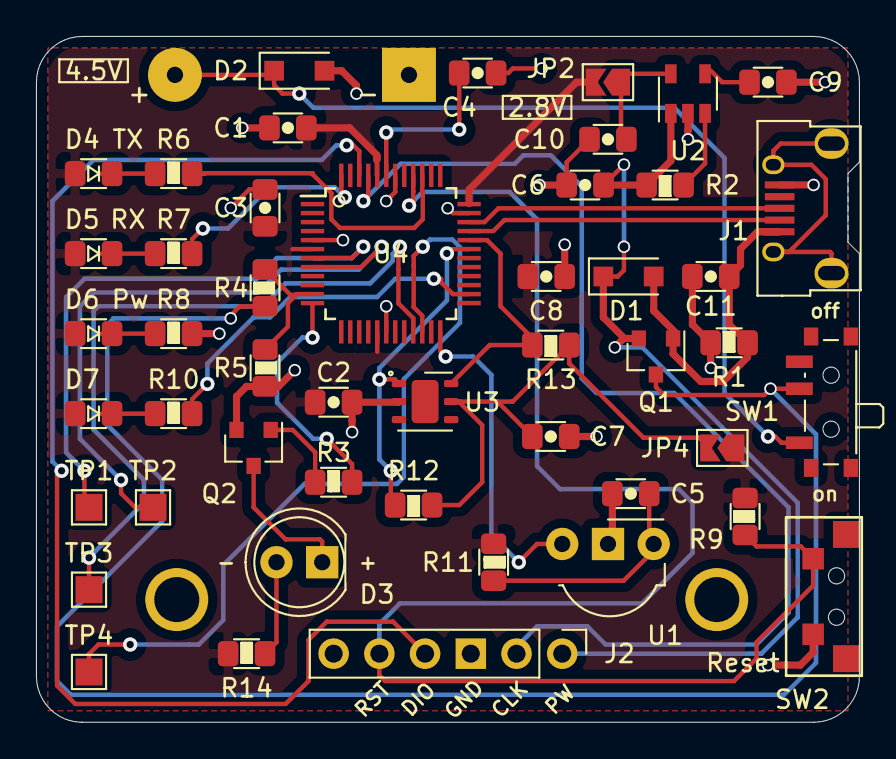
[picture p44: board Pine.kicad_pcb from above]

Board: 2 copper layers, 45.7 x 38.1 mm, 49 parts (0 on the bottom side), 36 nets.

Parts:
C1, C2, C3: 100nF; C_0805_2012Metric_Pad1.15x1.40mm_HandSolder
C4, C5, C6, C7, C10: 1uF; C_0805_2012Metric_Pad1.15x1.40mm_HandSolder
C8, C11: 10uF; C_0805_2012Metric_Pad1.15x1.40mm_HandSolder
C9: 10nF; C_0805_2012Metric_Pad1.15x1.40mm_HandSolder
D1, D2: Schottky diode; D_SOD-123F
D3: IR LED Emitter; LED_D5.0mm_IRGrey
D4, D5, D6, D7: LED Yellow; LED_0805_2012Metric_Pad1.15x1.40mm_HandSolder
J1: USB Micro type-B; USB_Micro-B_Horizontal-U254-051T-4BH23-S2B
J2: 01x06 Male conn; PinHeader_1x06_P2.54mm_Vertical
J3: Battery connector; BatteryHolder_Takachi_SN3-3PC_3AA
JP2, JP4: Open solder jumper; SolderJumper-2_P1.3mm_Open_TrianglePad1.0x1.5mm
Q1: p-channel MOSFET; SOT-23
Q2: NPN Transistor; SOT-23
R1, R9, R12, R13: 10k; R_0805_2012Metric_Pad1.15x1.40mm_HandSolder
R2, R4, R5: 100k; R_0805_2012Metric_Pad1.15x1.40mm_HandSolder
R3, R6, R7, R8, R10, R11: 470R; R_0805_2012Metric_Pad1.15x1.40mm_HandSolder
R14: 0R; R_0805_2012Metric_Pad1.15x1.40mm_HandSolder
SW1: Switch; SW_SPDT_PCM12
SW2: Push button; Tactile_pushbutton
TP1, TP2, TP3, TP4: TestPoint_Probe; TestPoint_Pad_1.5x1.5mm
U1: IR Receiver; Vishay_MOLD-3Pin
U2: LDO; SOT-23-5
U3: Temperature sensor; DFN-6-1EP_3x3mm_P1mm_EP1.5x2.4mm
U4: MCU; TQFP-48_7x7mm_P0.5mm

Connections:
+2V8: C1.1, C2.1, C3.1, C8.1, D4.2, D5.2, D6.2, D7.2, JP2.2, JP4.1, R9.2, R11.1, R14.1, U4.6, U4.17, U4.36, U4.44
/Batt: R4.2, R5.1, U4.11
/IR_Emitter: R3.2, U4.12
/IR_Receiver: U1.1, U4.24
/LED: R10.2, U4.26
/RST: J2.5, R9.1, SW2.1, U4.40
/RX_LED: R7.2, U4.48
/SCL: R13.2, U3.6, U4.32
/SDA: R12.2, U3.1, U4.31
/SWCLK: J2.2, U4.45
/SWDIO: J2.4, U4.46
/SWD_POWER_IN: C6.1, D1.1, J2.1, Q1.2, R2.2, U2.1
/TX_LED: R6.2, U4.39
/USB_D+: J1.3, U4.34
/USB_D-: J1.2, U4.33
/VBAT: Q1.3, R4.1, SW1.2
GND: C1.2, C2.2, C3.2, C4.1, C5.2, C6.2, C7.2, C8.2, C9.2, C10.2, C11.2, D2.2, J1.5, J2.3, J3.2, Q2.2, R1.1, R5.2, R8.2, SW2.2, U1.2, U2.2, U3.2, U4.5, U4.18, U4.35, U4.42
unnamed: C4.2, U4.43
unnamed: C5.1, R11.2, U1.3
unnamed: C7.1, JP4.2, R12.1, R13.1, U3.5
unnamed: C9.1, U2.4
unnamed: C10.1, JP2.1, U2.5
unnamed: C11.1, D1.2, J1.1, Q1.1, R1.2
unnamed: D2.1, J3.1, SW1.1
unnamed: D3.1, Q2.3
unnamed: D3.2, R14.2
unnamed: D4.1, R6.1
unnamed: D5.1, R7.1
unnamed: D6.1, R8.1
unnamed: D7.1, R10.1
unnamed: Q2.1, R3.1
unnamed: R2.1, U2.3
unnamed: TP1.1, U4.7
unnamed: TP2.1, U4.8
unnamed: TP3.1, U4.21
unnamed: TP4.1, U4.22
