hutscape/pine/_code/demo/data.h

// Sample raw IR code to turn ON and OFF aircon
// Aircon model: Mitsubishi MSY-GE10VA
#define RAW_DATA_LEN 292

uint16_t rawDataON[RAW_DATA_LEN]={
3446, 1716, 416, 1310, 413, 1318, 416, 451,
417, 451, 417, 450, 438, 1288, 421, 447,
416, 451, 438, 1292, 417, 1310, 421, 442,
438, 1288, 417, 455, 417, 450, 439, 1292,
416, 1310, 416, 451, 417, 1310, 434, 1292,
417, 446, 439, 437, 417, 1309, 417, 455,
434, 433, 412, 1314, 417, 451, 438, 429,
420, 451, 417, 451, 416, 447, 421, 446,
421, 446, 417, 455, 417, 446, 443, 433,
417, 446, 417, 451, 417, 451, 415, 451,
439, 434, 415, 451, 438, 434, 434, 434,
442, 433, 417, 450, 417, 1305, 438, 433,
418, 451, 407, 459, 408, 464, 416, 451,
416, 1310, 416, 1305, 421, 447, 416, 451,
407, 460, 417, 446, 416, 451, 417, 451,
416, 1305, 417, 446, 438, 434, 416, 451,
408, 460, 412, 455, 416, 1305, 416, 1310,
416, 451, 409, 1317, 407, 1323, 412, 460,
394, 473, 417, 451, 389, 477, 417, 451,
416, 451, 416, 456, 416, 447, 416, 1309,
417, 455, 416, 447, 412, 464, 416, 1306,
412, 455, 413, 459, 417, 1304, 390, 1341,
417, 446, 416, 451, 408, 460, 416, 451,
413, 454, 395, 473, 416, 451, 408, 465,
407, 464, 416, 451, 408, 464, 416, 451,
417, 451, 417, 446, 416, 455, 417, 446,
413, 459, 417, 446, 413, 459, 416, 451,
416, 460, 412, 456, 412, 455, 416, 451,
417, 450, 417, 455, 417, 451, 415, 451,
418, 445, 412, 456, 416, 452, 416, 451,
416, 451, 416, 451, 417, 447, 417, 450,
416, 451, 417, 450, 413, 459, 408, 460,
386, 481, 408, 460, 416, 451, 417, 451,
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
438, 429, 434, 433, 448, 433, 442, 430,
438, 429, 421, 446, 439, 433, 421, 447,
421, 446, 439, 429, 438, 429, 421, 442,
439, 430, 441, 430, 416, 451, 421, 447,
438, 433, 416, 1306, 438, 1288, 421, 1305,
434, 1292, 417, 451, 420, 443, 438, 429,
421, 447, 430, 1000};
