hutscape/pine/(commit log)

2019-07-25 First commit
    Chinmay Pendharkar <notthetup@gmail.com>
    [Pine.kicad_pcb, Pine.sch]
2019-07-25 [docs] Remove unused bom includes
2019-08-08 [docs] Add user stories on indicating status through an on-board RGB LED
2019-08-20 [design] Update firmware for IR receive and emit with SAMD21 board
    [Pine.sch]
2019-08-20 [design] Add BOM so far
    [_saved_Pine.sch, bill_of_materials.csv]
2019-08-20 [design] Update BOM with MCU dev board
    [Pine.sch, _saved_Pine.sch, bill_of_materials.csv]
2019-08-20 [bom] Fix bom generation script if no MPN
    [bill_of_materials.csv]
2019-08-20 [bom] No fix
    [bill_of_materials.csv]
2019-08-20 [docs] Remove previous EFM32 prototype image
2019-08-20 [design] Switch to an active /dev/cu.usbmodem port
2019-08-21 [docs] Add BOM iterator
2019-08-25 [docs] Add some links for power
2019-08-27 [design] Add I2C temperature sensor
    [Pine.sch]
2019-09-02 [design] Add power tree schematic
2019-09-03 [design] Add webusb code to store user config for interval, duration and temperature
2019-09-08 [docs] Add schematic reference links for SAMD21
2019-09-08 [docs] Update BOM and script
    [bill_of_materials.csv]
2019-09-09 [design] Change schematic to draw power from 3.3V only
    [Pine.sch]
2019-09-09 [docs] Move power tree schematic to power page
2019-09-10 [design] Amend power tree schematic
2019-09-11 [design] Add operating voltage info for chips
    [Pine.sch]
2019-09-11 [design] Update power tree with AP2112 output voltage
2019-09-11 [design] Update schematic with SAMD21 chip instead of dev board
    [Pine.sch]
2019-09-11 [design] Generate new BOM based on updated schematic
    [bill_of_materials.csv]
2019-09-11 [design] Update schematic and BOM with Si7021 chip instead of module
    [Pine.sch, bill_of_materials.csv]
2019-09-11 [docs] Create BOM analytics from a single python script
    [bill_of_materials.csv]
2019-09-11 [design] Update schematic with LED circuits
    [Pine.sch]
2019-09-11 [design] Update schematic with LED circuit
    [Pine.sch, bill_of_materials.csv]
2019-09-12 [design] Fix MOSFET direction with pins source and drain
    [Pine.sch]
2019-09-15 [design] Add 0ohm resistors for circuit isolation
    [Pine.sch]
2019-09-16 [design] Remove MOSFET from LED
    [Pine.sch, bill_of_materials.csv]
2019-09-16 [design] Add SWD connector for programming the bootloader
    [Pine.sch, bill_of_materials.csv]
2019-09-16 [design] Update BOM with vendor links
    [Pine.sch, bill_of_materials.csv]
2019-09-16 [docs] Update BOM format
2019-09-17 [design] Add power management circuit simulation
    [Pine.sch]
2019-09-17 [design] Replace 0ohm resistors with solder jumpers
    [Pine.sch, bill_of_materials.csv]
2019-09-17 [design] Indicate DNP parts
    [Pine.sch, bill_of_materials.csv]
2019-09-17 [docs] Add DNP info in BOM
2019-09-18 [docs] Move power images and add circuit simulation video
2019-09-18 [design] Indicate internal stock for BOM
    [Pine.sch, bill_of_materials.csv]
2019-09-18 [design] Add battery holder
    [Pine.sch, bill_of_materials.csv]
2019-09-19 [design] Add power management circuit simulation without inverter and USB ID pin
    [Pine.sch]
2019-09-19 [design] DNP TX/RX LEDs
    [Pine.sch, bill_of_materials.csv]
2019-09-19 [docs] Remove unneccesary unique parts of populate number
    [_saved_Pine.sch]
2019-09-19 [design] Add battery voltage measurement circuit
    [Pine.sch, _saved_Pine.sch, bill_of_materials.csv]
2019-09-19 [design] Add more info to BOM
    [Pine.sch, bill_of_materials.csv]
2019-09-19 [docs] Improve BOM page
2019-09-19 [design] Add passives based on datasheet sample application circuit for IR receiver and sensor
    [Pine.sch, bill_of_materials.csv]
2019-09-22 [design] Add application circuit for new LDO
    [Pine.sch]
2019-09-22 [design] Update BOM with more passive for application circuits
    [Pine.sch, bill_of_materials.csv]
2019-09-22 [design] Update BOM with footprint
    [Pine.sch, bill_of_materials.csv]
2019-09-22 [design] Cleanup BOM
    [Pine.sch, bill_of_materials.csv]
2019-09-22 [design] Design new footprint for USB Micro-B connector
    [Pine.sch]
2019-09-23 Update BOM
    [Pine.sch]
2019-09-23 [design] Associate battery holder with footprint
    [Pine.sch]
2019-09-23 [design] Setup initial rat's nest with parts and footprints matched
    [Pine.kicad_pcb, Pine.sch]
2019-09-23 [design] Enable measuring battery voltage by connecting to GPIO. close #3
    [Pine.kicad_pcb, Pine.sch]
2019-09-23 [design] Improve power management circuit
    [Pine.sch]
2019-09-24 [design] Update BOM with power management circuit tweaks
    [Pine.kicad_pcb, Pine.sch, bill_of_materials.csv]
2019-10-11 feat: add sorting and searching for bom
    [bill_of_materials.csv]
2019-10-11 feat: add yellow LED in value for BOM
    [Pine.sch, bill_of_materials.csv]
2019-10-12 feat: tweak BOM column header and serial column
2019-10-20 feat: Place components without for mechanical considerations
    [Pine.kicad_pcb]
2019-10-23 feat: place components mechanically with silkscreen annotations
    [Pine.kicad_pcb, Pine.sch]
2019-10-24 fix: improve components placement. close #9
    [Pine.kicad_pcb, Pine.sch]
2019-10-24 feat: export schematic, ibom and layout files
    [Pine.kicad_pcb, Pine.sch]
2019-10-24 feat: add references for RC circuit and measuring power. close #7
2019-10-24 fix: use older breadboard schematic for getting started instructions
    [Pine.kicad_pcb]
2019-10-24 feat: change footprint to layout naming
2019-10-24 feat: add download buttons on getting started page
2019-10-24 feat: continue with routing
    [Pine.kicad_pcb]
2019-10-25 feat: add 4 test points in schematic and layout. close #6
    [Pine.kicad_pcb, Pine.sch]
2019-10-26 feat: complete first cut routing with DRC passing
    [Pine.kicad_pcb]
2019-10-26 feat: improve routing
    [Pine.kicad_pcb]
2019-10-27 feat: add new LDO to power component analysis. close #10
2019-10-27 feat: update power tree schematic with new LDO LD3985 output voltage 2.8V
2019-10-27 feat: update all schematic and layout images with iBom. close #12
    [Pine.kicad_pcb, Pine.sch]
2019-10-27 feat: change to a clear LED to depict the 3D of IR emitter:
    [Pine.kicad_pcb]
2019-10-28 feat: add meta data for download buttons on start page
2019-10-28 feat: add button link for gerber files
2019-10-28 feat: Add improvements done to current project
2019-10-29 fix: interchange source and drain labels for the MOSFET. #14
    [Pine.sch]
2019-10-29 fix: remove image for transistor to keep in view the transistor info
    [Pine.sch]
2019-10-29 fix: remove redundant solder jumper. #14
    [Pine.kicad_pcb, Pine.sch]
2019-10-29 docs: export update schematic without solder jumper JP1. #14
2019-10-30 fix: remove BATT_EN and link to GND. #14
    [Pine.kicad_pcb, Pine.sch]
2019-10-30 fix: add series resistor to IR LED. #14
    [Pine.kicad_pcb, Pine.sch, bill_of_materials.csv]
2019-10-30 docs: add layout pdf with series resistor of IR LED. #14
2019-10-30 docs: update BOM with category
    [Pine.sch, bill_of_materials.csv]
2019-10-31 feat: add detailed title block for schematic
    [Pine.sch]
2019-10-31 feat: improve annotations in schematic
    [Pine.sch]
2019-11-01 feat: change all 2v8 labels to power symbols
    [Pine.sch]
2019-11-03 chore: update all assets before manufacturing
    [Pine.kicad_pcb, Pine.sch, bill_of_materials.csv]
2019-11-03 feat: render gerber files for PCB manufacturing
    [Pine-B_Cu.gbr, Pine-B_Mask.gbr, Pine-B_Paste.gbr, Pine-B_SilkS.gbr, Pine-Edge_Cuts.gbr, Pine-F_Cu.gbr, Pine-F_Mask.gbr, Pine-F_Paste.gbr]
2019-11-04 fix: add gerber file download buttons
2019-11-04 feat: sort vendor column in BOM and add checkbox
2019-11-07 feat: add notes for BOM column
2019-11-11 chore: update git submodules for scripts and bom
2019-11-11 refactor: update schottky diode with another part number
    [Pine.sch, bill_of_materials.csv]
2019-11-16 docs: update stock
    [Pine.sch, bill_of_materials.csv]
2019-11-16 feat: display internal stock number if env is dev
    [bill_of_materials.csv]
2019-11-17 fix: invert the switch on/off silkscreen. close #17
    [Pine.kicad_pcb]
2019-11-18 chore: update submodules with global and project specific symbols and footprints
2019-11-22 fix: move D6Pw label on silkscreen to D6 Pw
    [Pine.kicad_pcb]
2019-11-28 chore: update KiCad 5.1.5
2019-12-08 docs: add reference on forum topic for arduino zero bootloader with STLink
2020-07-01 docs: add standard 9-pin jtag/swd connector in V++
2020-07-07 refactor: add note on the crystalless PCB
    [Pine.kicad_pcb]
2020-07-07 docs: add test serial monitor results
    [Pine.kicad_pcb]
2020-07-09 test: add test firmware
    [Pine.kicad_pcb]
2020-07-20 docs: add resources on debugging low IR LED range
2020-07-29 refactor: update arduino-cli commands
2020-08-13 fix: invert pin 1 and 2 for Q2 BC817 instead of PN222N
    [Pine.kicad_pcb, Pine.sch]
2020-08-14 feat: add LEDs in subsystem block diagram
2020-08-16 refactor: amend IR resistor to lower value to increase IR range
    [Pine.sch]
2020-09-05 refactor: update arduino-cli version
2020-09-06 fix: add vendor id for arduino zero
2020-09-07 refactor: add debug prints
2020-09-07 refactor: move all sensor code into folder
2020-09-16 docs: update getting started page with the manufactured and tested custom PCB
2020-09-16 docs: update hardware schematic and layout files
    [Pine.kicad_pcb, Pine.sch]
2020-09-16 refactor: rename image case
2020-10-06 fix: add IR Raw code array length
    [data.h]
2020-10-08 docs: add a note on improving reverse polarity circuit protection
2021-06-26 chore: upgrade dependancies
    [bill_of_materials.csv]
2021-08-23 refactor: combine design, power and mechanical into design
2021-09-10 fix: reset fonts after inserting iBom
2021-11-11 refactor: put the prototype image at the top of examples
2022-04-20 refactor: make a parent data node for download buttons
2022-04-21 refactor: remove gerber_url to link to GitHub releases page
    [Pine-B_Cu.gbr, Pine-B_Mask.gbr, Pine-B_Paste.gbr, Pine-B_SilkS.gbr, Pine-Edge_Cuts.gbr, Pine-F_Cu.gbr, Pine-F_Mask.gbr, Pine-F_Paste.gbr]
2022-04-21 "refactor: seperate BOM page into more partials"
2022-05-18 "feat: add 18650 battery 3D model to KiCad library"
2022-05-19 "feat: add stub antenna 3D model to KiCad library"
2022-05-19 "feat: add /case layout for projects with enclosure designs"
2022-07-21 refactor: rename hardware layout to pcb
2022-07-21 refactor: rename directory from hardware to pcb
    [Pine.kicad_pcb, Pine.sch]
2022-07-22 chore: move images from hardware to pcb directory
2022-07-25 feat: add 3d printed case photos
2024-02-26 feat: update submodules for unique SMT, DNP and TH BOM parts
2024-02-29 chore: update submodules to seperate /case page into sections
2024-02-29 chore: update submodules to display manufacturing params for case
2024-03-04 feat: display all prototype images until defined max_prototype_images
2024-03-15 chore: update submodules to display software bill of materials
2024-04-01 chore: update submodules to display manufactured PCBs
2024-04-11 feat: add a new power page
2024-04-11 docs (power): remove HTML and convert content to only markdown
2024-05-01 chore: update submodules to sync BOM stats with the manufacturer
2024-11-14 chore: update submodule to conditionally display edit button
